cskilbeck/clock/Outputs/2020-09-30/Produce_DanZhi.SMT_Snapshot.Top.2367869A_Y37.SMT020093082196.png

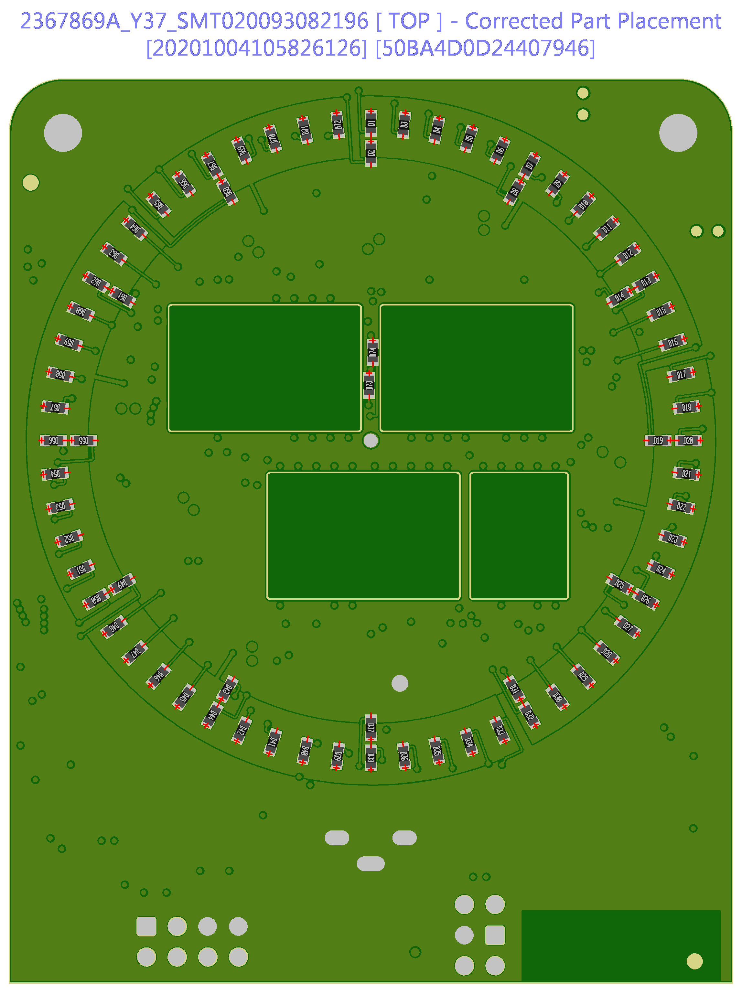
Outputs/2020-09-30/Produce_DanZhi.SMT_Snapshot.Top.2367869A_Y37.SMT020093082196.png
