cskilbeck/clock/Outputs/2020-09-30/SO2009306134.png

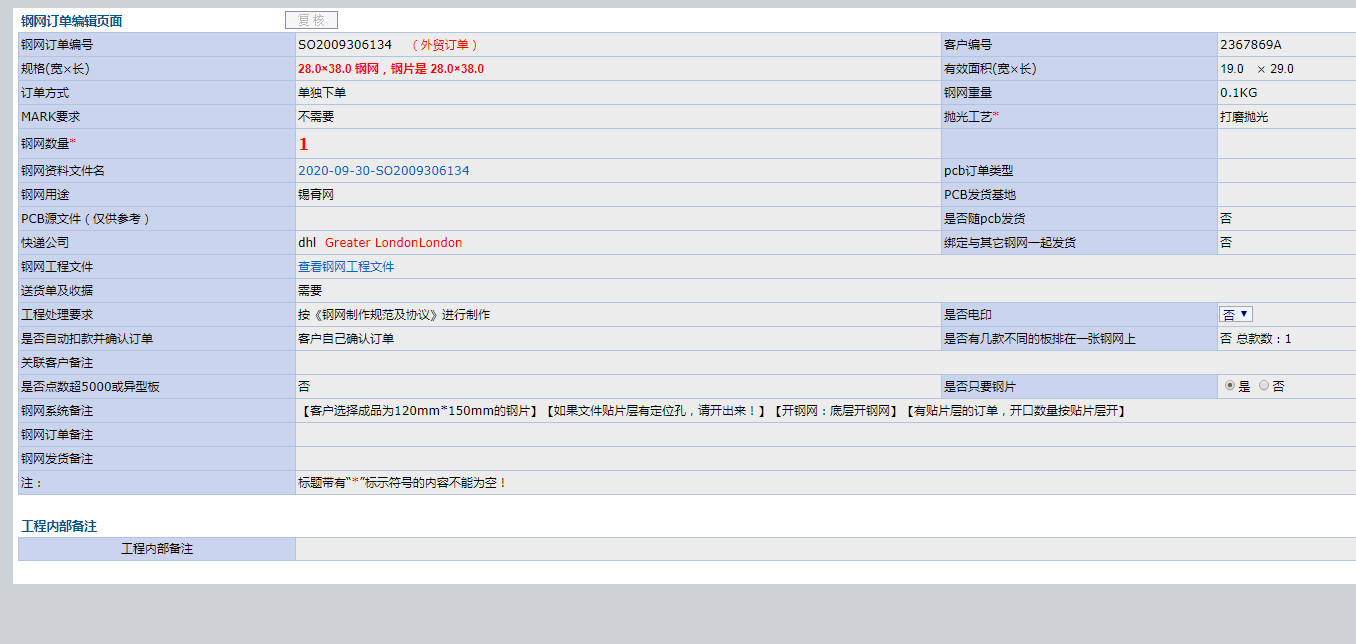
Outputs/2020-09-30/SO2009306134.png
