cskilbeck/clock/Outputs/2020-10-29/Produce_DanZhi.SMT_Snapshot.Top.2367869A_Y39.SMT020102993842.png

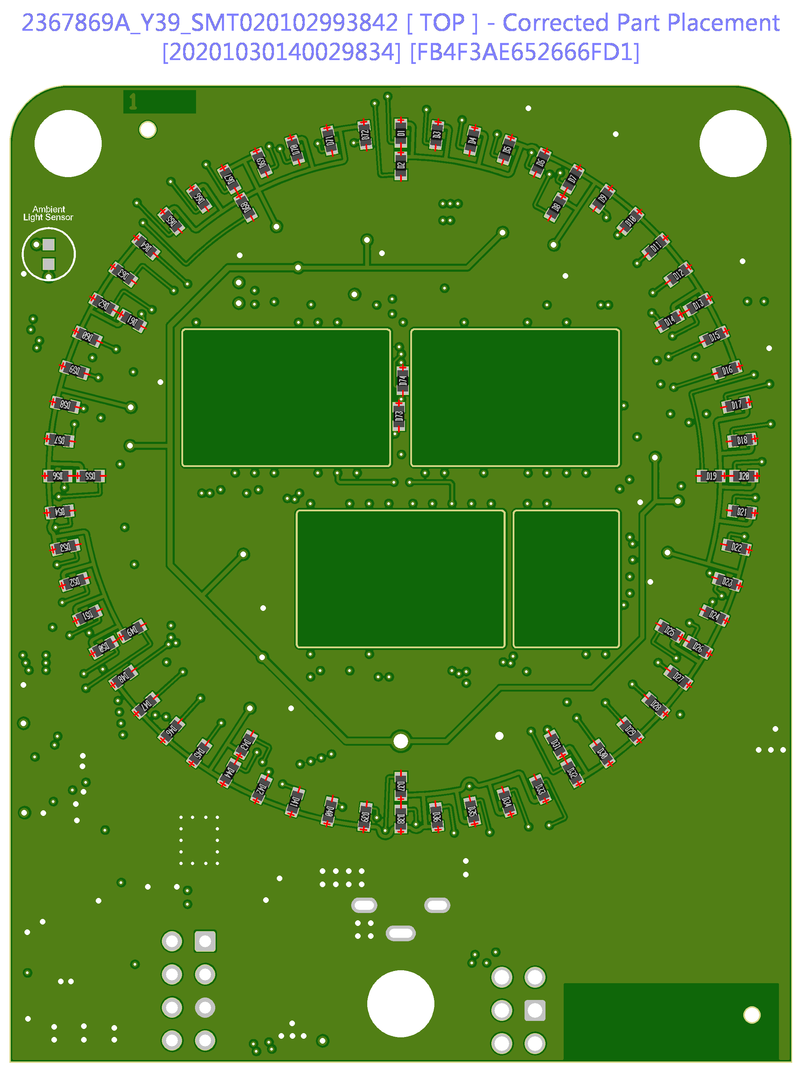
Outputs/2020-10-29/Produce_DanZhi.SMT_Snapshot.Top.2367869A_Y39.SMT020102993842.png
