cskilbeck/clock/Outputs/2020-11-24/BOM.xlsx

Comment | Designator | Footprint | LCSC Part #（optional）
LED | D1 | LED_0603 | C2286
LED | D2 | LED_0603 | C2286
LED | D3 | LED_0603 | C2286
LED | D4 | LED_0603 | C2286
LED | D5 | LED_0603 | C2286
LED | D6 | LED_0603 | C2286
LED | D7 | LED_0603 | C2286
LED | D8 | LED_0603 | C2286
LED | D9 | LED_0603 | C2286
LED | D10 | LED_0603 | C2286
LED | D11 | LED_0603 | C2286
LED | D12 | LED_0603 | C2286
LED | D13 | LED_0603 | C2286
LED | D14 | LED_0603 | C2286
LED | D15 | LED_0603 | C2286
LED | D16 | LED_0603 | C2286
LED | D17 | LED_0603 | C2286
LED | D18 | LED_0603 | C2286
LED | D19 | LED_0603 | C2286
LED | D20 | LED_0603 | C2286
LED | D21 | LED_0603 | C2286
LED | D22 | LED_0603 | C2286
LED | D23 | LED_0603 | C2286
LED | D24 | LED_0603 | C2286
LED | D25 | LED_0603 | C2286
LED | D26 | LED_0603 | C2286
LED | D27 | LED_0603 | C2286
LED | D28 | LED_0603 | C2286
LED | D29 | LED_0603 | C2286
LED | D30 | LED_0603 | C2286
LED | D31 | LED_0603 | C2286
LED | D32 | LED_0603 | C2286
LED | D33 | LED_0603 | C2286
LED | D34 | LED_0603 | C2286
LED | D35 | LED_0603 | C2286
LED | D36 | LED_0603 | C2286
LED | D37 | LED_0603 | C2286
LED | D38 | LED_0603 | C2286
LED | D39 | LED_0603 | C2286
LED | D40 | LED_0603 | C2286
LED | D41 | LED_0603 | C2286
LED | D42 | LED_0603 | C2286
LED | D43 | LED_0603 | C2286
LED | D44 | LED_0603 | C2286
LED | D45 | LED_0603 | C2286
LED | D46 | LED_0603 | C2286
LED | D47 | LED_0603 | C2286
LED | D48 | LED_0603 | C2286
LED | D49 | LED_0603 | C2286
LED | D50 | LED_0603 | C2286
LED | D51 | LED_0603 | C2286
LED | D52 | LED_0603 | C2286
LED | D53 | LED_0603 | C2286
LED | D54 | LED_0603 | C2286
LED | D55 | LED_0603 | C2286
LED | D56 | LED_0603 | C2286
LED | D57 | LED_0603 | C2286
LED | D58 | LED_0603 | C2286
LED | D59 | LED_0603 | C2286
LED | D60 | LED_0603 | C2286
LED | D61 | LED_0603 | C2286
LED | D62 | LED_0603 | C2286
LED | D63 | LED_0603 | C2286
LED | D64 | LED_0603 | C2286
LED | D65 | LED_0603 | C2286
LED | D66 | LED_0603 | C2286
LED | D67 | LED_0603 | C2286
LED | D68 | LED_0603 | C2286
LED | D69 | LED_0603 | C2286
LED | D70 | LED_0603 | C2286
LED | D71 | LED_0603 | C2286
LED | D72 | LED_0603 | C2286
LED | D73 | LED_0603 | C2286
LED | D74 | LED_0603 | C2286
