cskilbeck/clock/step/RV-8263-C7 v1.step

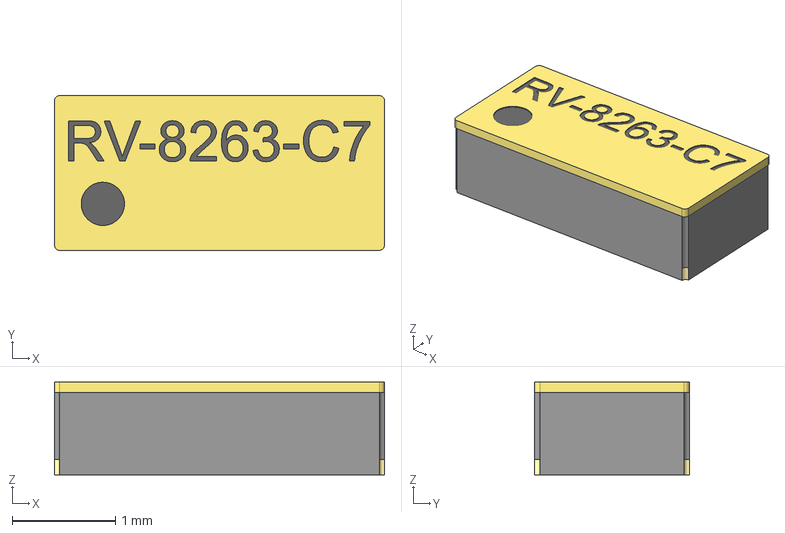
[picture p4: CAD file, 2020-11-23]
step/RV-8263-C7 v1.step
3.20 x 1.50 x 0.9 mm
