cskilbeck/clock/step/ACSA56-51.STEP

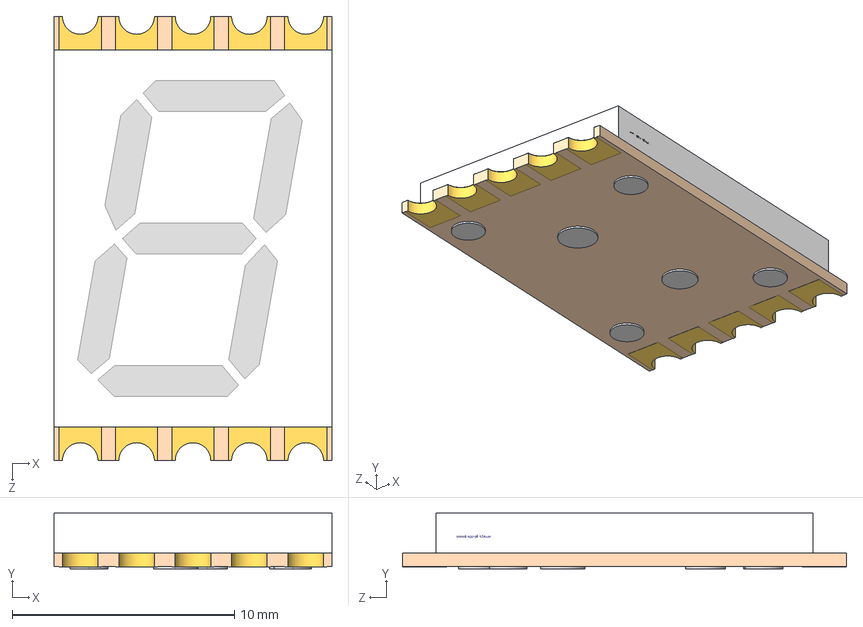
[picture p5: CAD file, 2020-11-18]
step/ACSA56-51.STEP
12.5 x 2.50 x 20.0 mm
