cskilbeck/clock/step/KCSA03-105.1.step

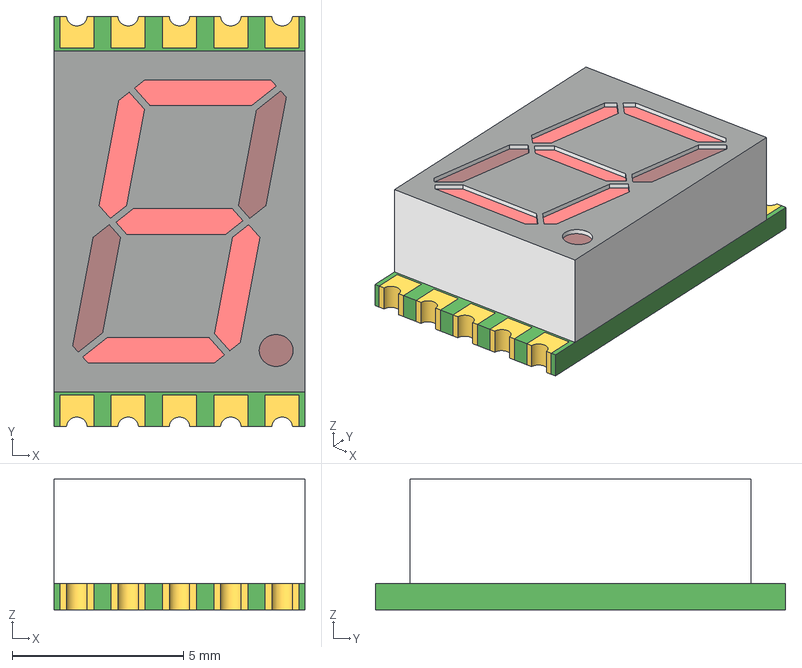
[picture p6: CAD file, 2020-11-05]
step/KCSA03-105.1.step
7.34 x 12.0 x 3.83 mm
