cskilbeck/clock/step/ALS-PDIC144-6C.STEP

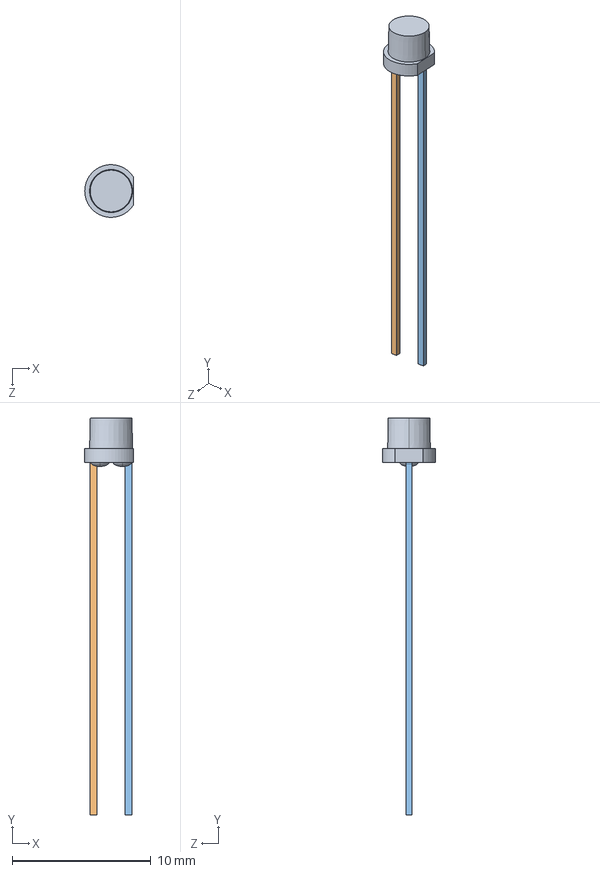
[picture p7: CAD file, 2020-11-05]
step/ALS-PDIC144-6C.STEP
3.50 x 28.6 x 3.80 mm
