cskilbeck/clock/step/DSM7UA30101.STEP

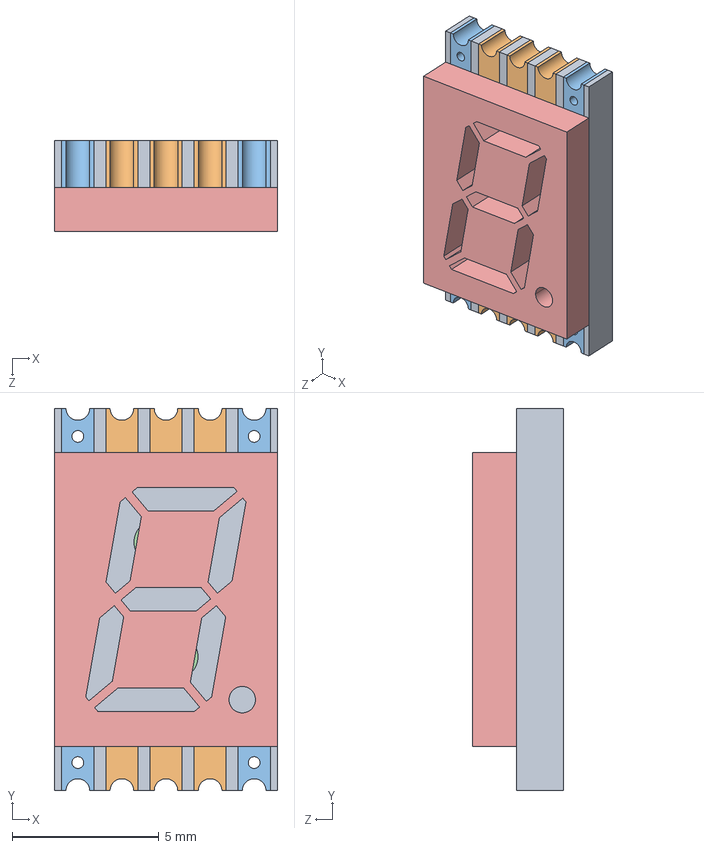
[picture p8: CAD file, 2020-11-05]
step/DSM7UA30101.STEP
7.60 x 13.0 x 3.10 mm
S3012PCB.1.STEP
S3012PCB.2.STEP x 6
S3012PCB.3.STEP x 4
S3012PCB.4.STEP x 2
S3012___r.STEP
