cskilbeck/clock/step/ALS-PDIC144-6C_BENT_LEGS4.step

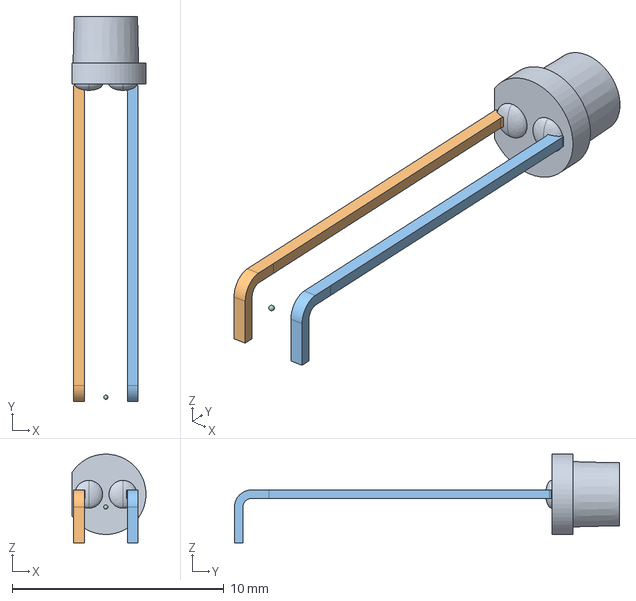
[picture p9: CAD file, 2020-11-05]
step/ALS-PDIC144-6C_BENT_LEGS4.step
3.50 x 18.2 x 4.20 mm
