cskilbeck/clock/step/ALS-PDIC144-6C_BENT_LEGS.step

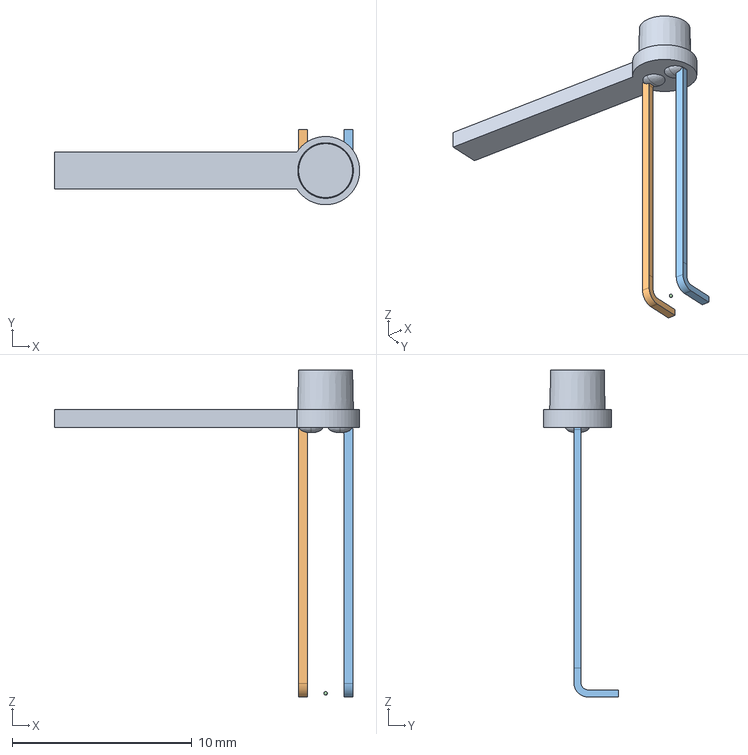
[picture p11: CAD file, 2020-11-05]
step/ALS-PDIC144-6C_BENT_LEGS.step
17.0 x 4.20 x 18.2 mm
