cskilbeck/clock/step/LED_0603_KT-0603R.step

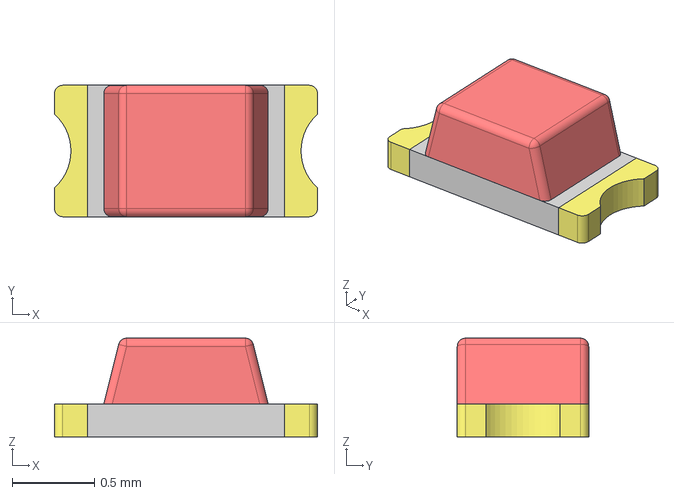
[picture p13: CAD file, 2020-10-22]
step/LED_0603_KT-0603R.step
1.60 x 0.8 x 0.6 mm
