cskilbeck/clock/step/ALS_2012_0805_R5.step

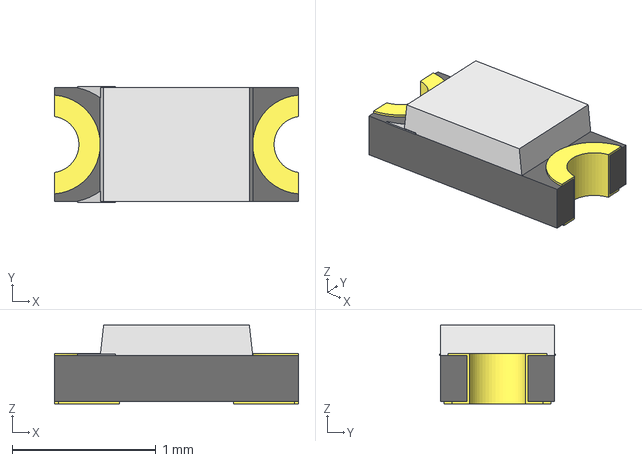
[picture p14: CAD file, 2020-10-13]
step/ALS_2012_0805_R5.step
1.70 x 0.807 x 0.547 mm
