cskilbeck/clock/step/ALS_2012_0805_r3.step

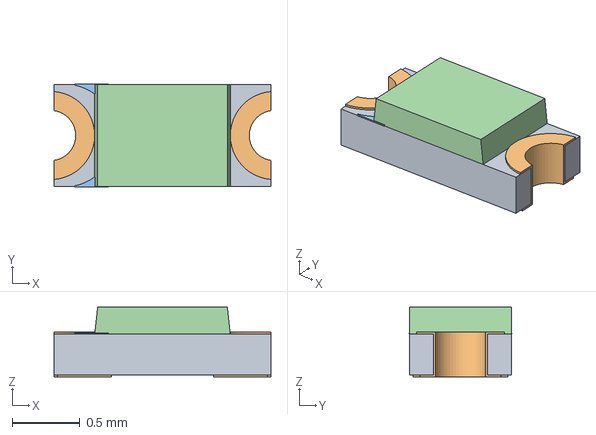
[picture p15: CAD file, 2020-10-13]
step/ALS_2012_0805_r3.step
1.60 x 0.759 x 0.515 mm
