cskilbeck/clock/step/usb_connector v8.step

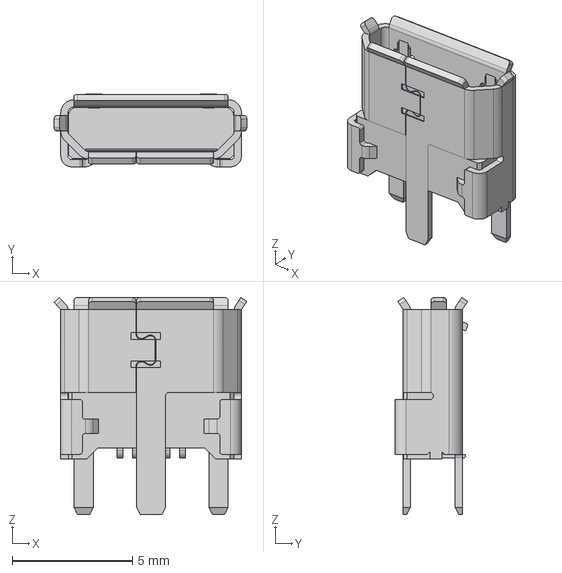
[picture p16: CAD file, 2020-10-13]
step/usb_connector v8.step
8.00 x 3.01 x 9.01 mm
