cskilbeck/clock/step/ALS_2012_0805_R2.step

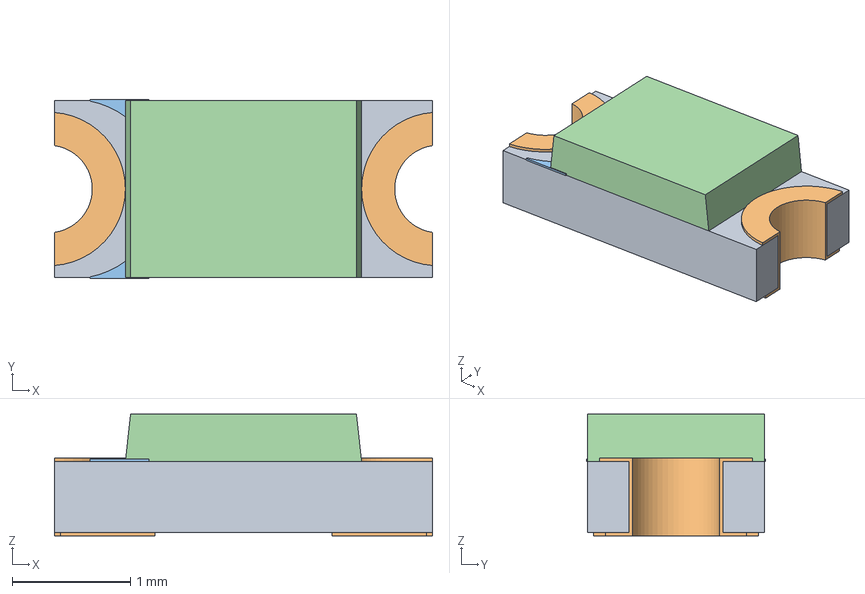
[picture p17: CAD file, 2020-10-13]
step/ALS_2012_0805_R2.step
3.20 x 1.52 x 1.03 mm
