cskilbeck/clock/step/RK10J1_E.STEP

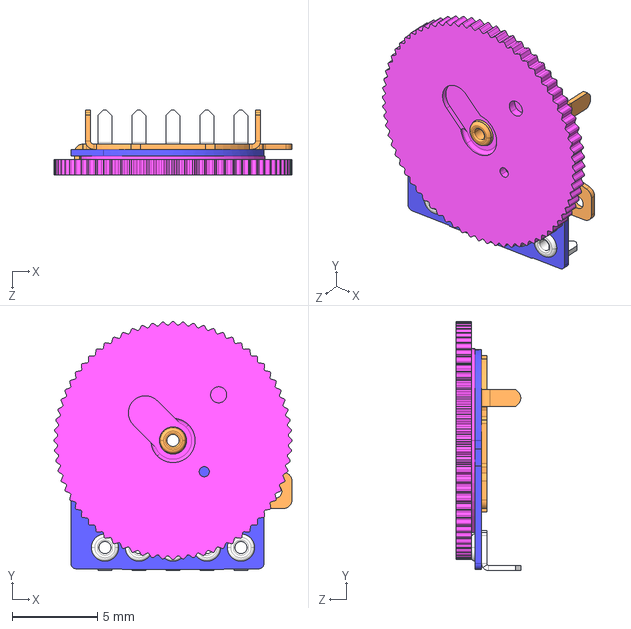
[picture p18: CAD file, 2020-10-13]
step/RK10J1_E.STEP
14.0 x 14.6 x 3.80 mm
