cskilbeck/clock/step/RK10J1_R.STEP

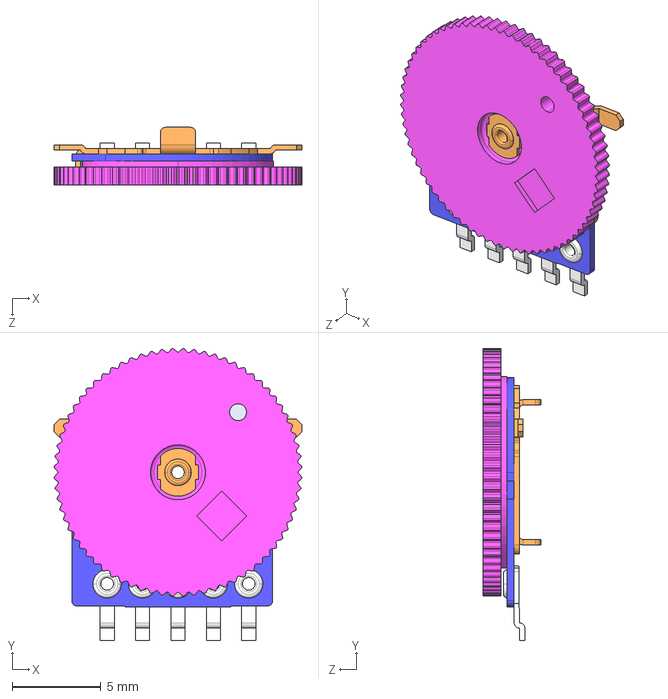
[picture p19: CAD file, 2020-10-13]
step/RK10J1_R.STEP
14.0 x 16.5 x 3.25 mm
