cskilbeck/clock/(list of files, cad)

Other CAD files:
step/ALS-PDIC144-6C_BENT_LEGS3.step
step/ALS-PDIC144-6C_BENT_LEGS2.step
step/KCSA03-105.step
step/ALS_2012_0805_r4.step
step/ALS_2012_0805.STEP
step/DSM7UA30101_rev01.step
