cskilbeck/clock/Outputs/2020-11-24/clock.PDF

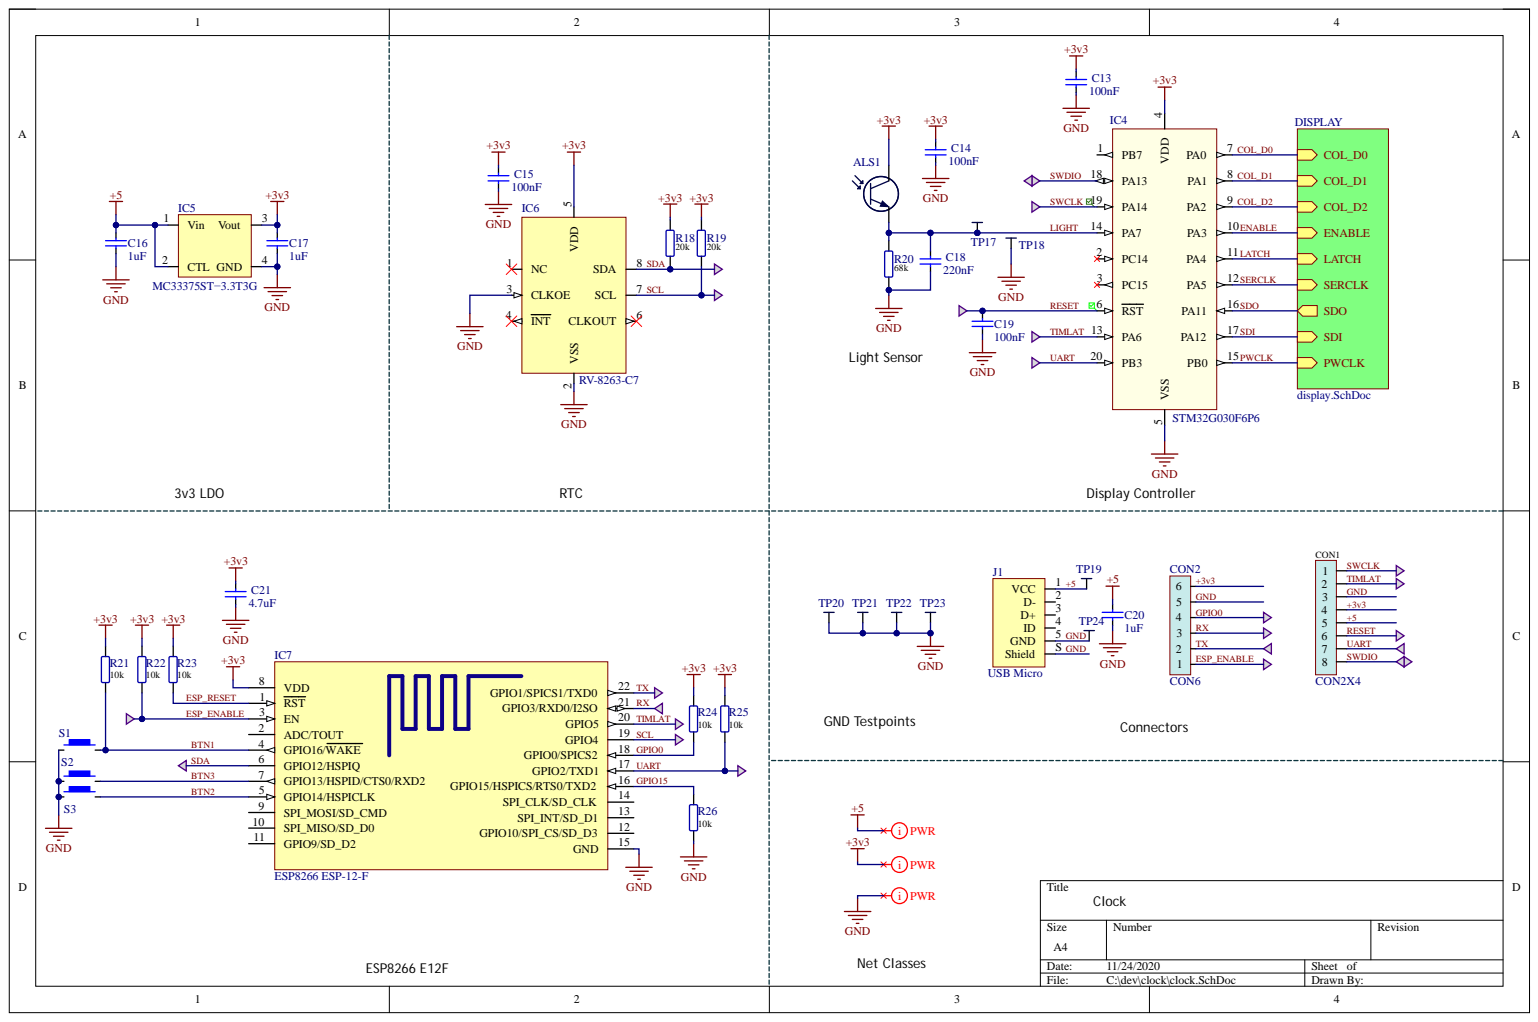
[picture p20: page 1]

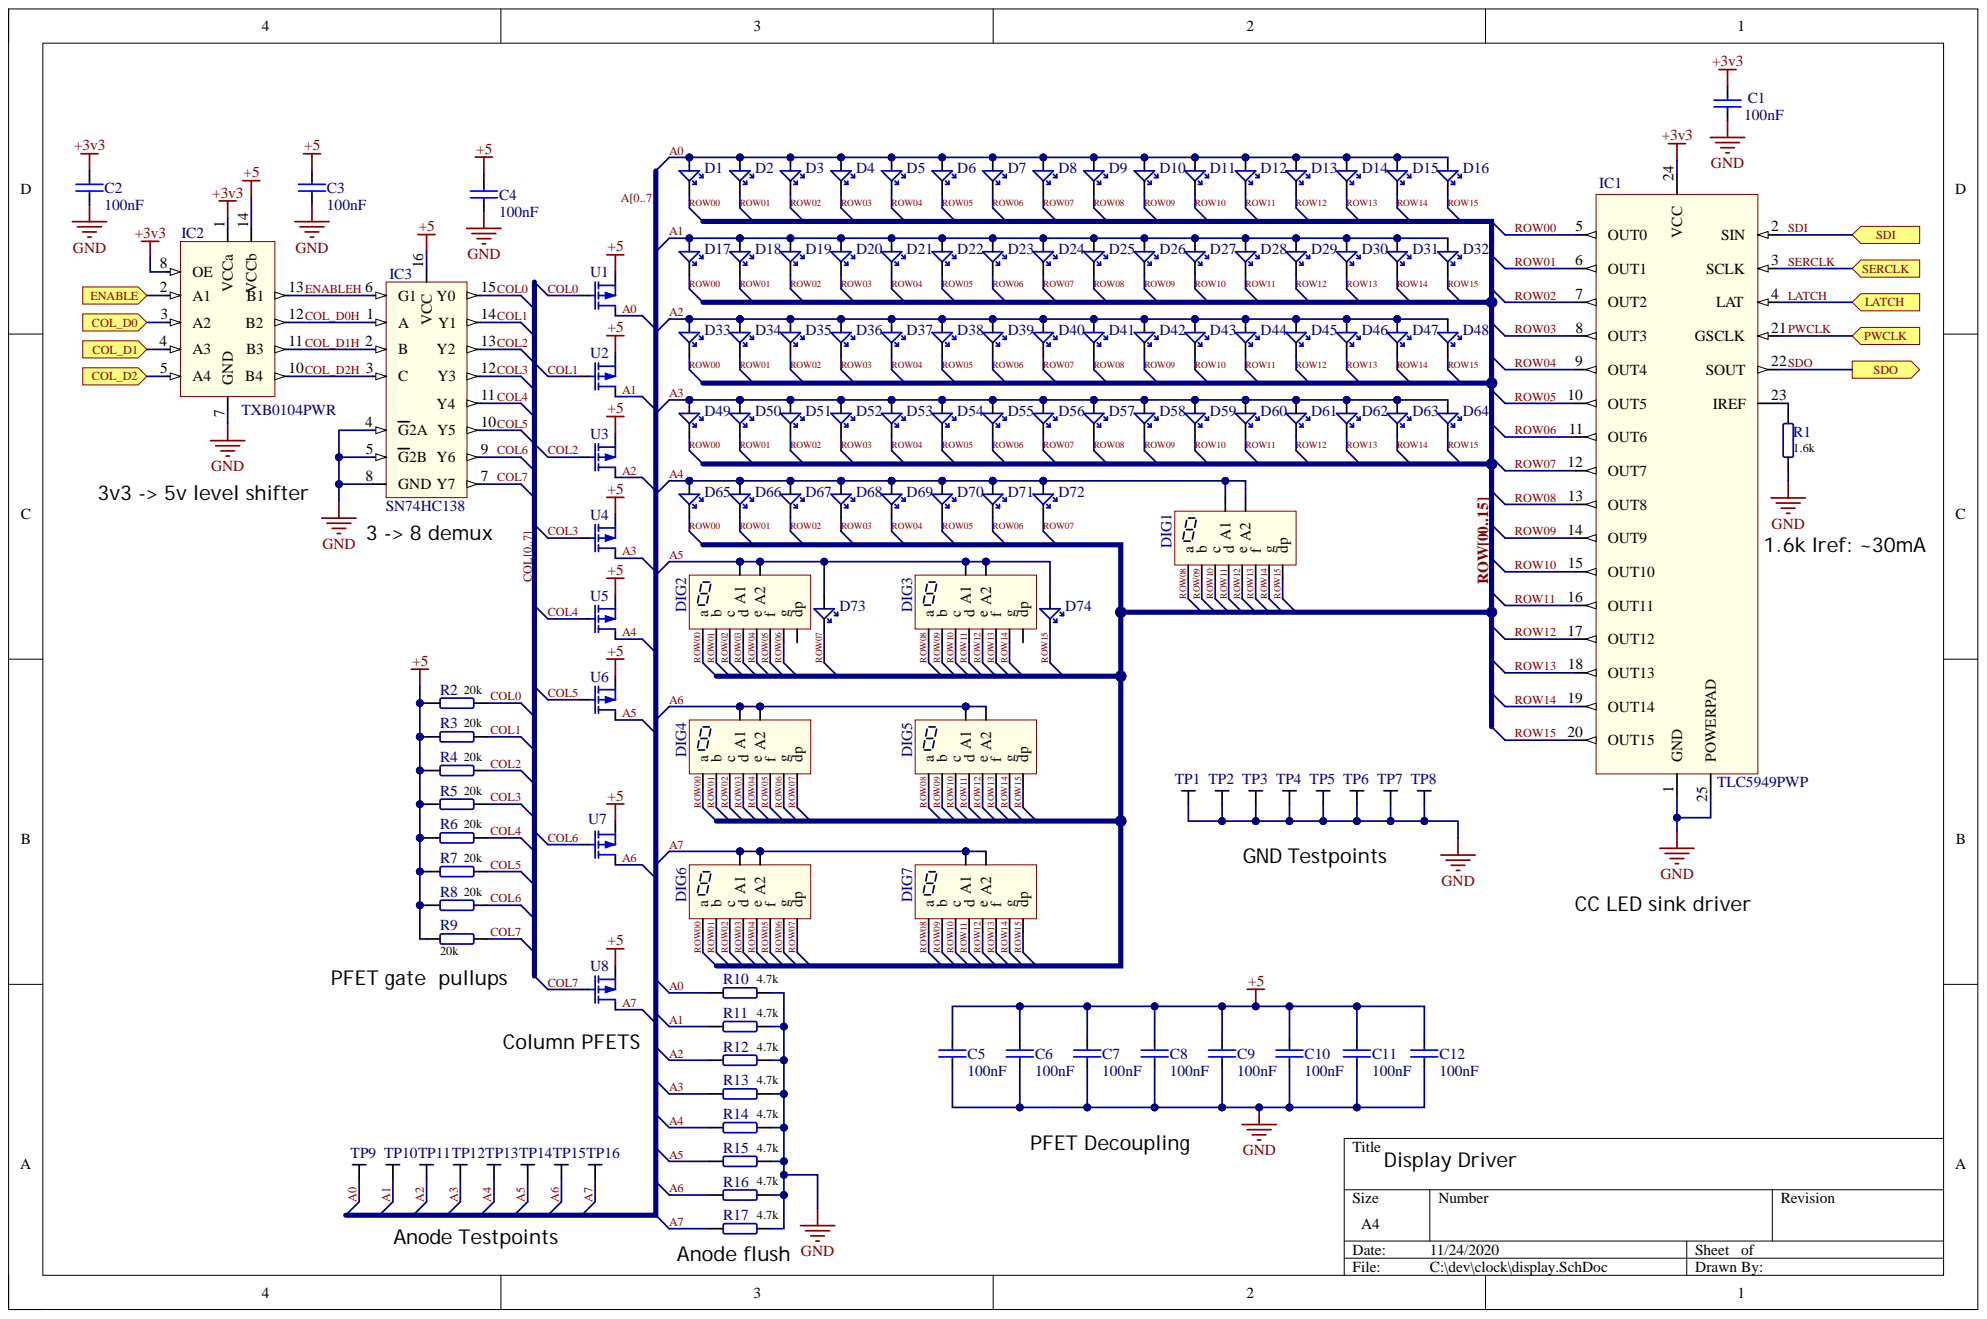
[picture p21: page 2]

CC LED sink driver

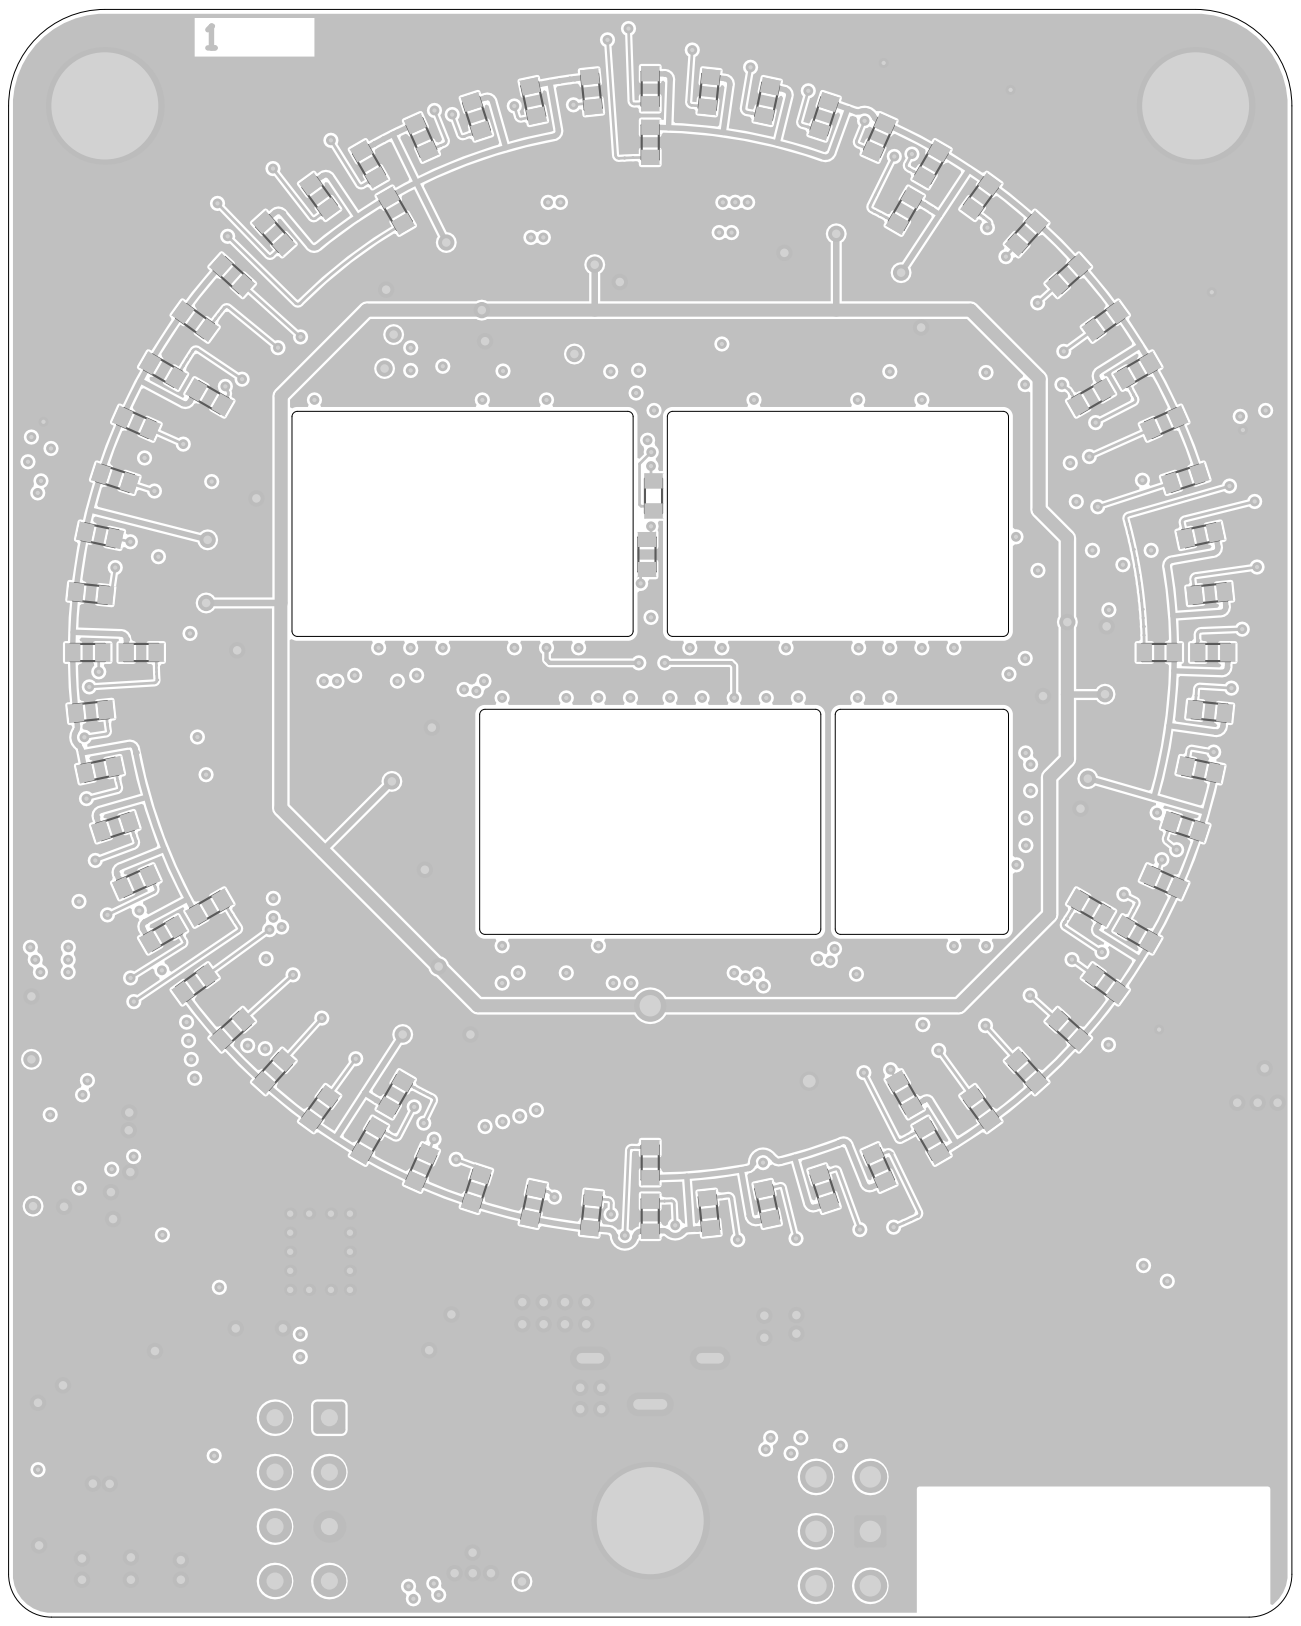
[picture p22: page 3]

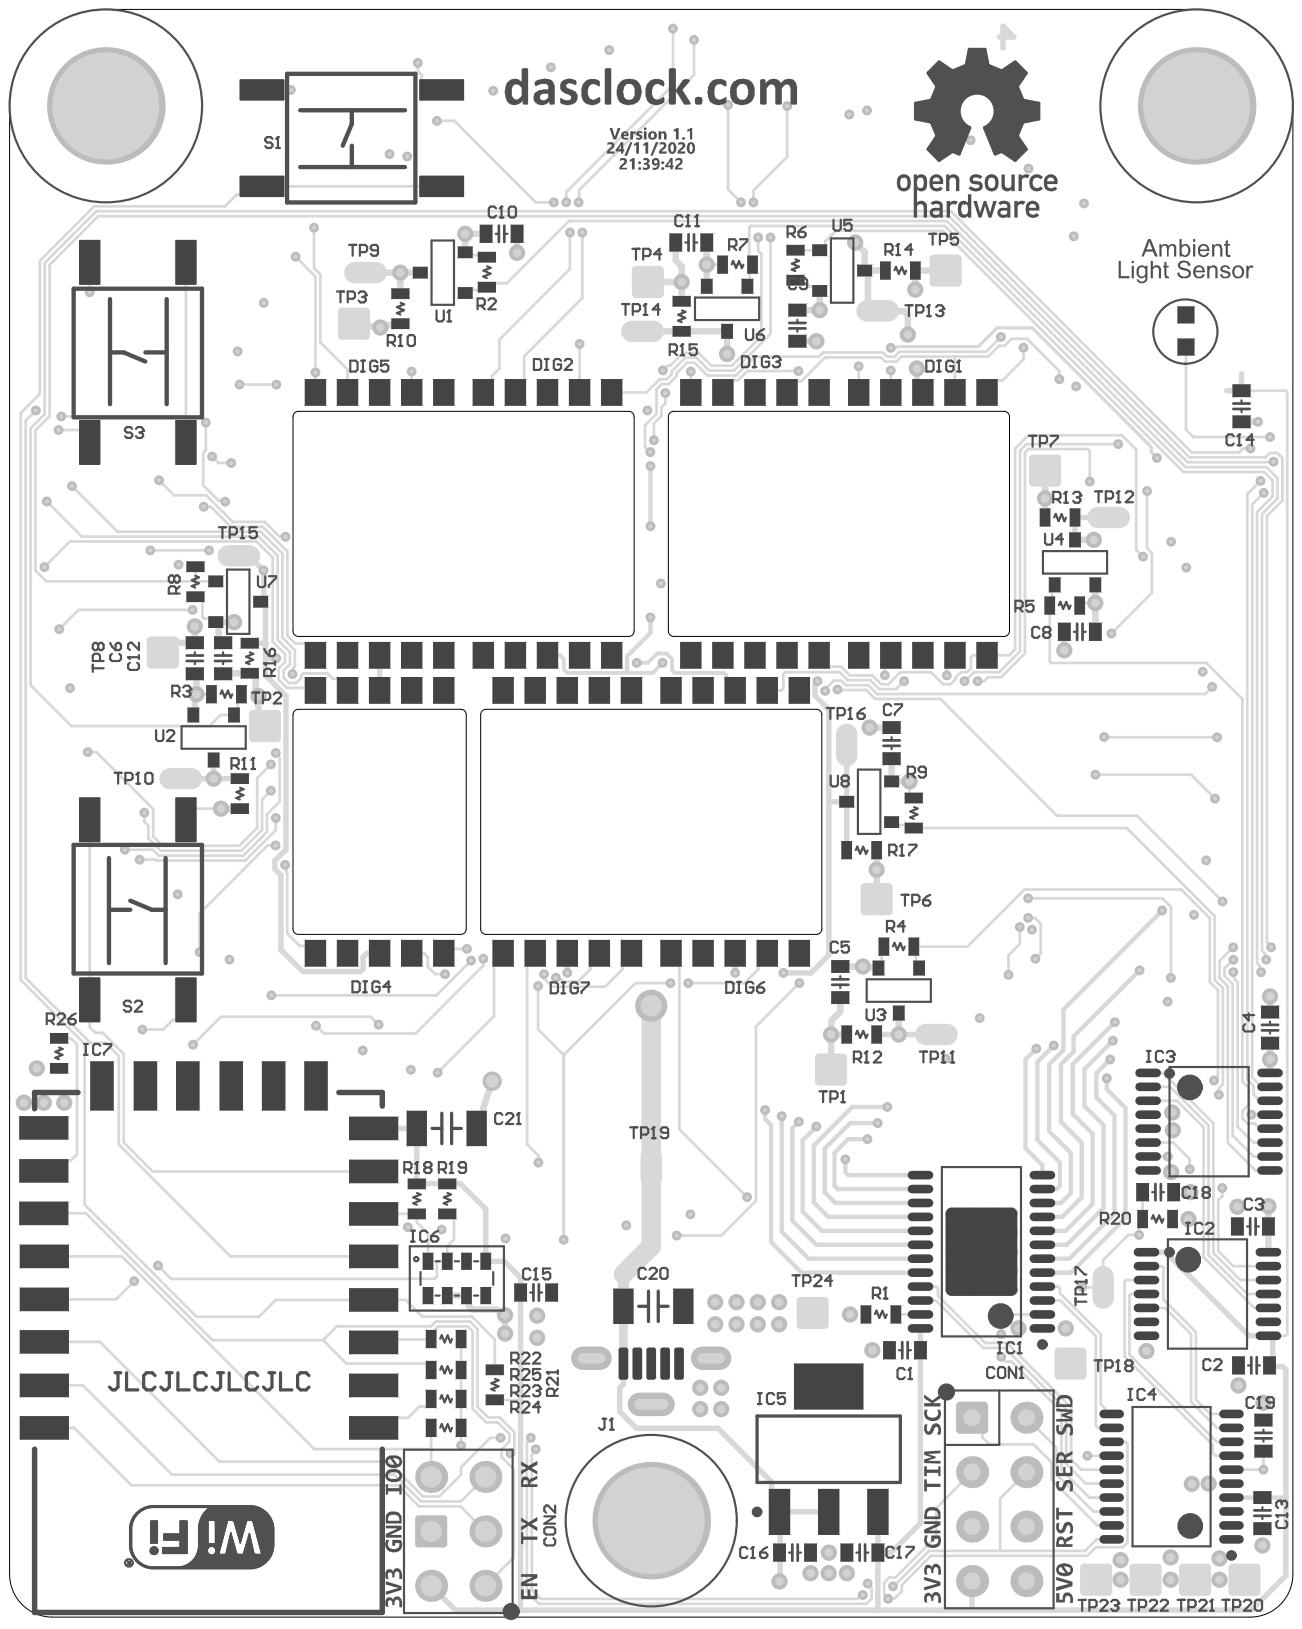
[picture p23: page 4]

Designator | Value | Quantity | Name | Footprint | Description
ALS1 | | 1 PHOTOTRANSISTOR | | ALS-PT19-315C | Photo transistor
C1-C15, C19 | 100nF | 16 Cap | | CAPC_0603_1608X08L | Capacitor
C16, C17 | 1uF | 2 Cap | | CAPC_0603_1608X08L | Capacitor
C18 | 220nF | 1 Cap | | CAPC_0603_1608X08L | Capacitor
C20 | 1uF | 1 Cap | | CAPC_1206_3216X16L | Capacitor
C21 | 4.7uF | 1 Cap | | CAPC_1206_3216X16L | Capacitor
D1-D74 | | 74 LED | | 0603 Chip SMD LED | Red 0603 SMD LED
DIG1-DIG7 | | 7 KCSA03-105 | | KCSA03105 | Low profile 7 segment digit
IC1 | | 1 TLC5949PWP | | TSOP65P640X120-24L - POWERPAD | 16 channel cc sink led driver
IC2 | | 1 TXB0104PWR | | TSOP65P640X120-14L | 4 channel level shifter
IC3 | | 1 SN74HC138 | | TSOP65P640X110-16L | 3 -> 8 demux
IC4 | | 1 STM32G030F6P6 | | TSOP65P630X120-20L | MCU 64MHz tssop20
IC5 | | 1 MC33375ST−3.3T3G | | SOT230P700X180-4N | 3.3v LDO
IC6 | | 1 RV-8263-C7 | | RV-8263-C7
IC7 | | 1 ESP8266 ESP-12-F | | ESP8266 ESP-12-E | ESP8266 ESP-12-F
J1 | | 1 USB Micro | | USB 1051330011 | USB 2.0 Type B Micro vertical SMT
R1 | 1.6k | 1 RES0603 | | RESC1608X03L | Chip Resistor
R2-R9, R18, R19 | 20k | 10 RES0603 | | RESC1608X03L | Chip Resistor
R10-R17 | 4.7k | 8 RES0603 | | RESC1608X03L | Chip Resistor
R20 | 68k | 1 RES0603 | | RESC1608X03L | Chip Resistor
R21-R26 | 10k | 6 RES0603 | | RESC1608X03L | Chip Resistor
S1-S3 | | 3 4-1437565-1 | | FSM-SWITCH | 6x6mm SMD tactile switch,SPST-NO
U1-U8 | | 8 MOSFET-P | | SOT95P230X110-3L | P channel mosfet 1.2A

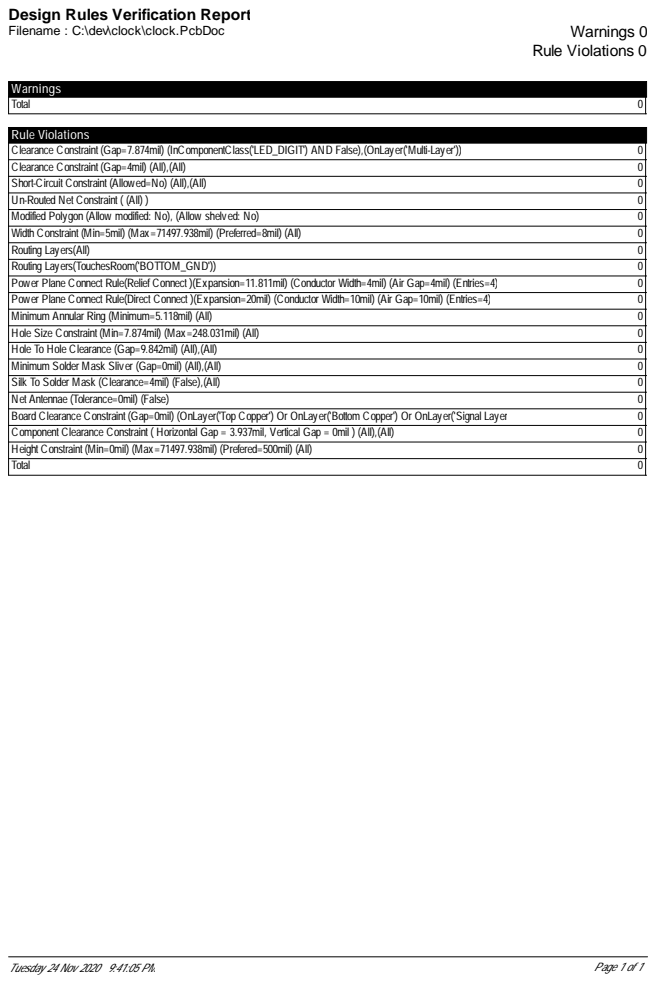
[picture p24: page 6]

Design Rules Verification Report

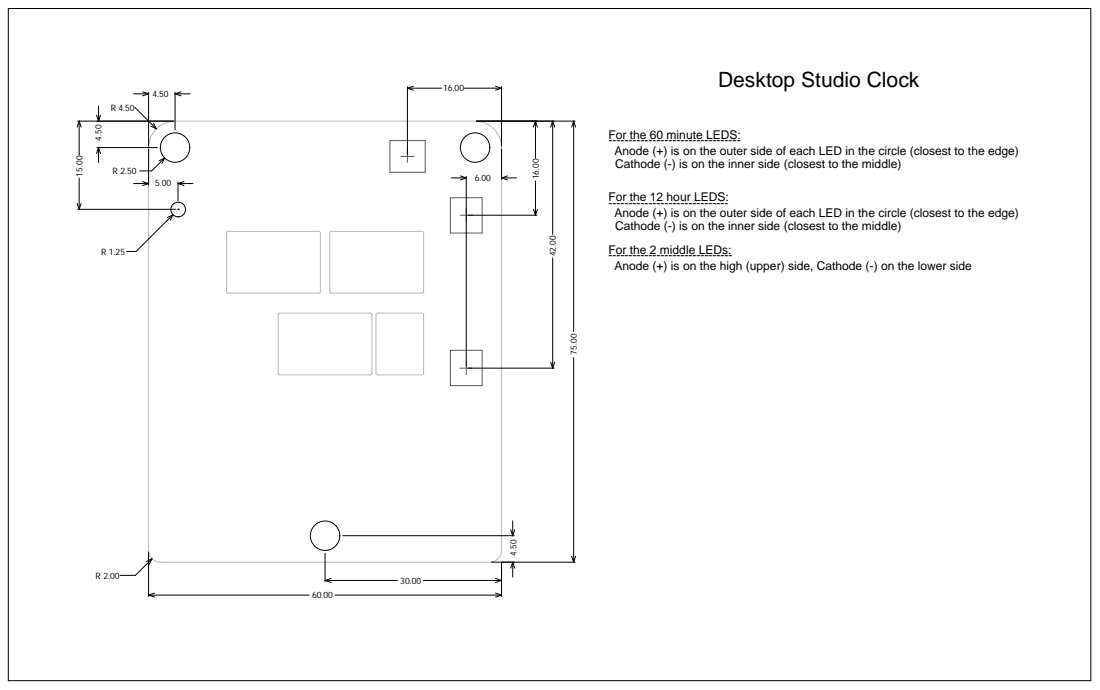
[picture p25: page 7]

For the 60 minute LEDS:
Anode (+) is on the outer side of each LED in the circle (closest to the edge)
Cathode (-) is on the inner side (closest to the middle)

For the 12 hour LEDS:

For the 2 middle LEDs:
Anode (+) is on the high (upper) side, Cathode (-) on the lower side
