cskilbeck/clock/Outputs/2020-10-29/clock.PDF

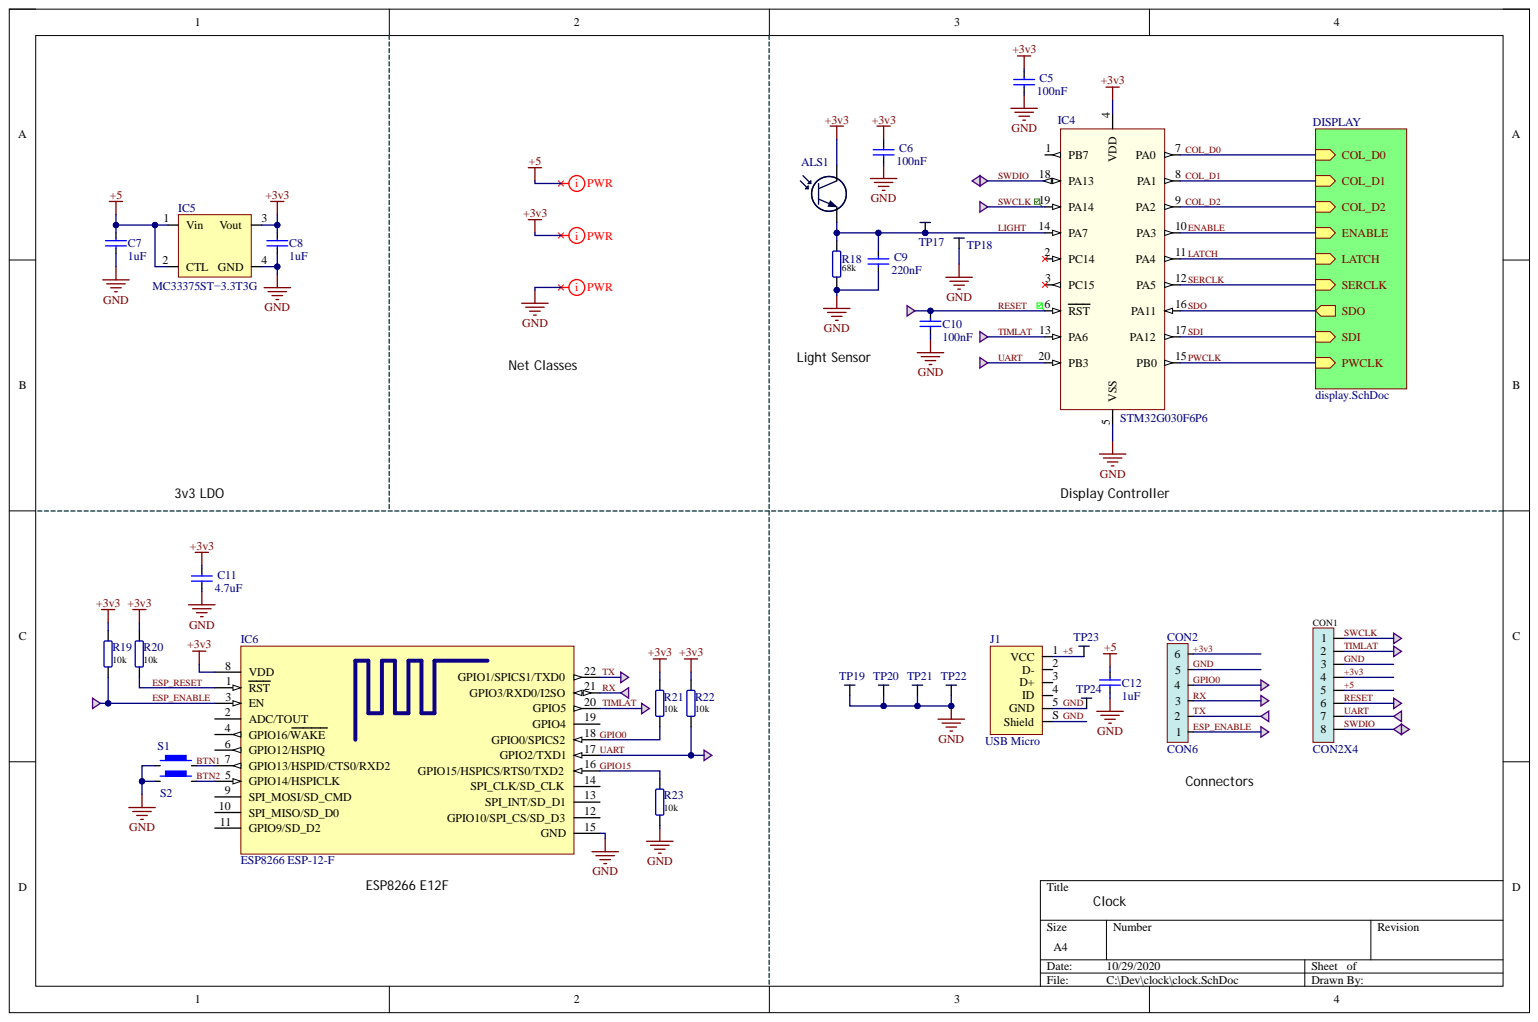
[picture p26: page 1]

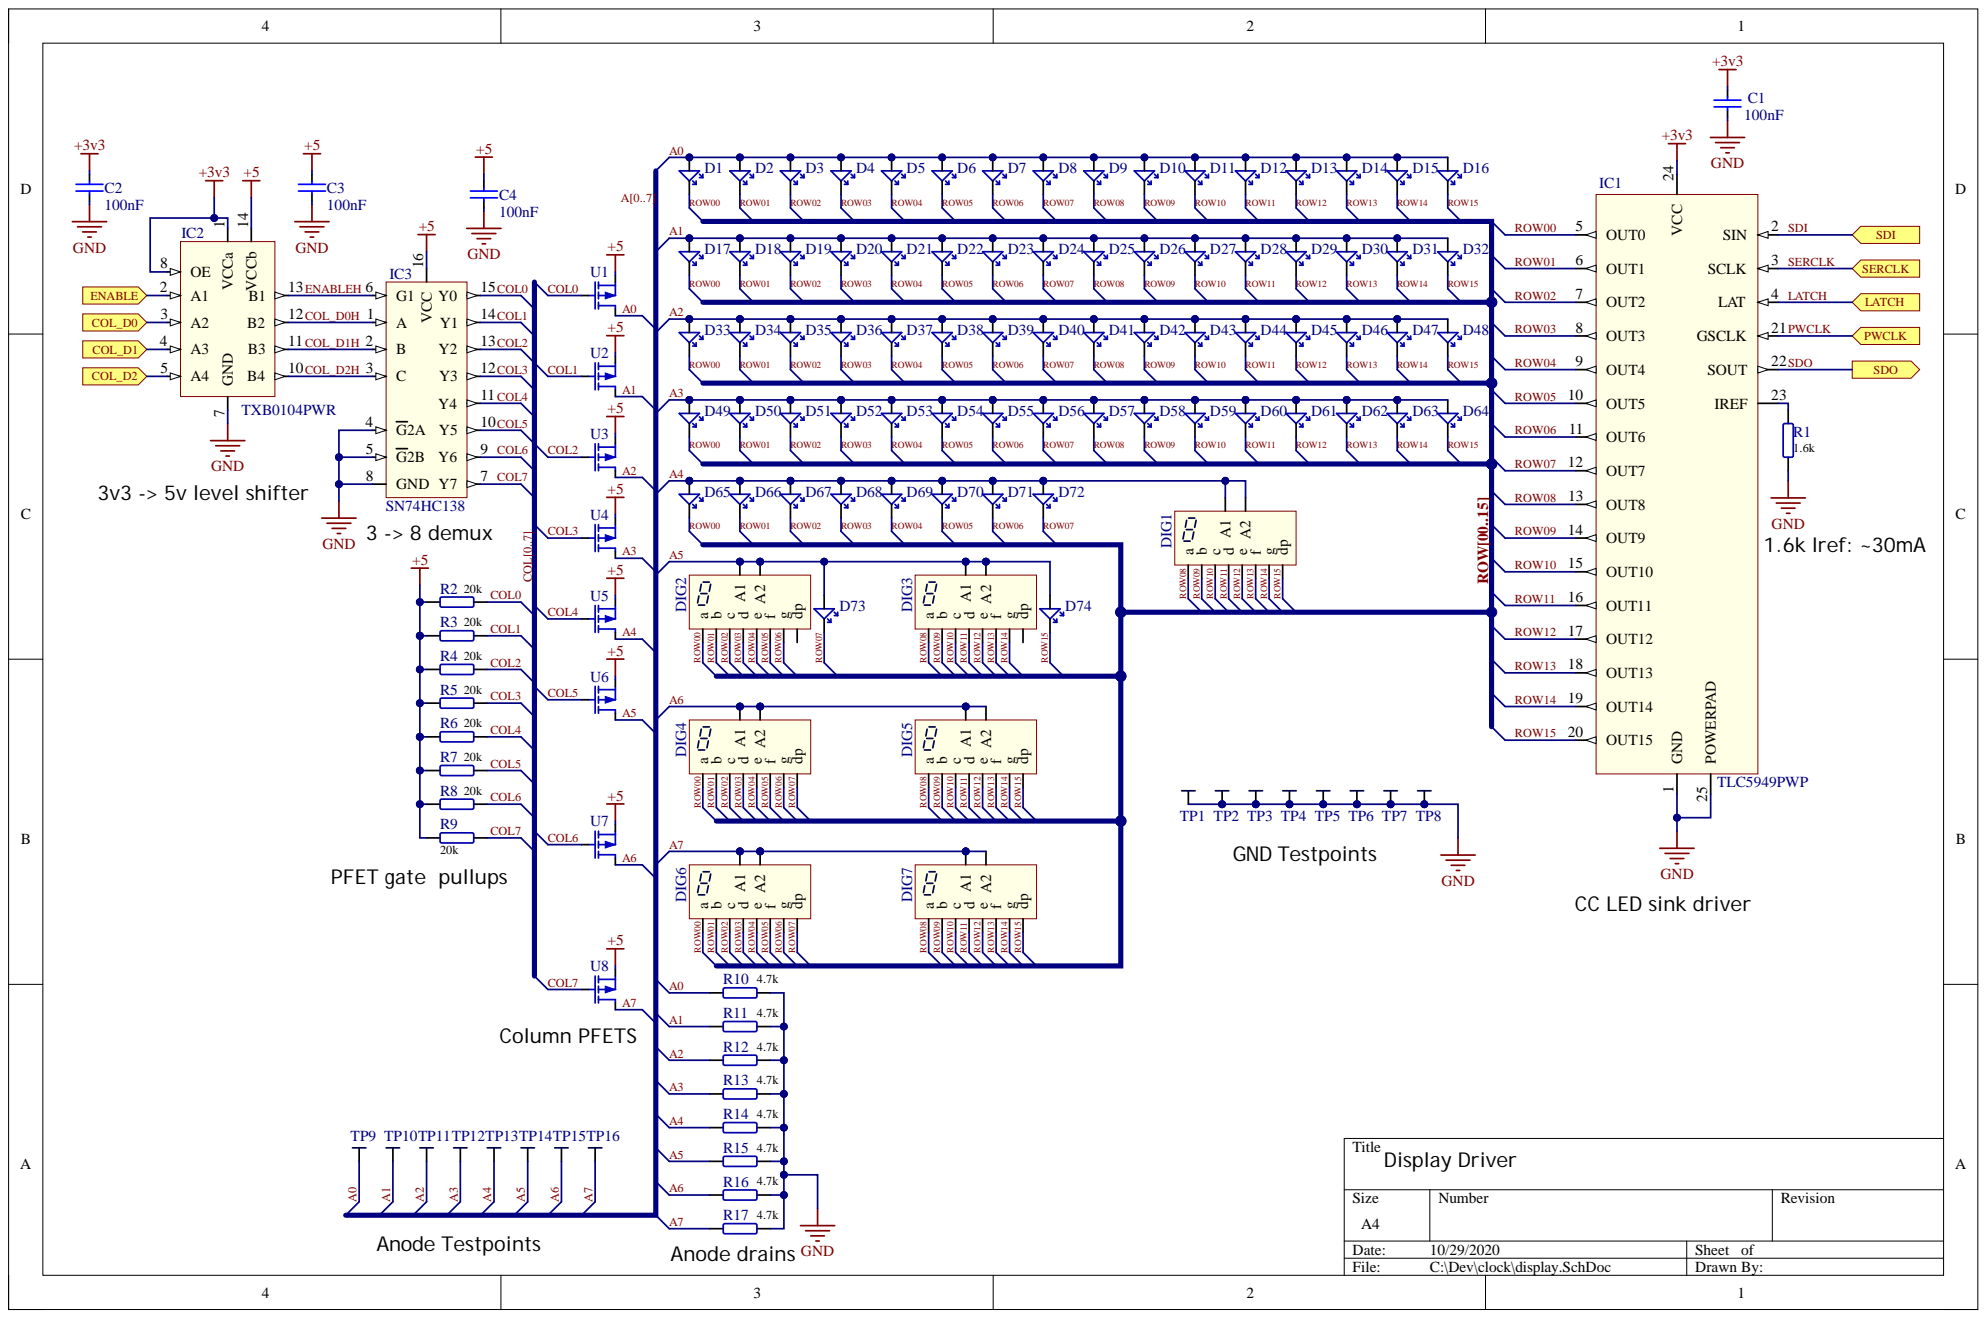
[picture p27: page 2]

1 1 COL_D1 | H 2

COL_D2 | 3 H

CC LED sink driver

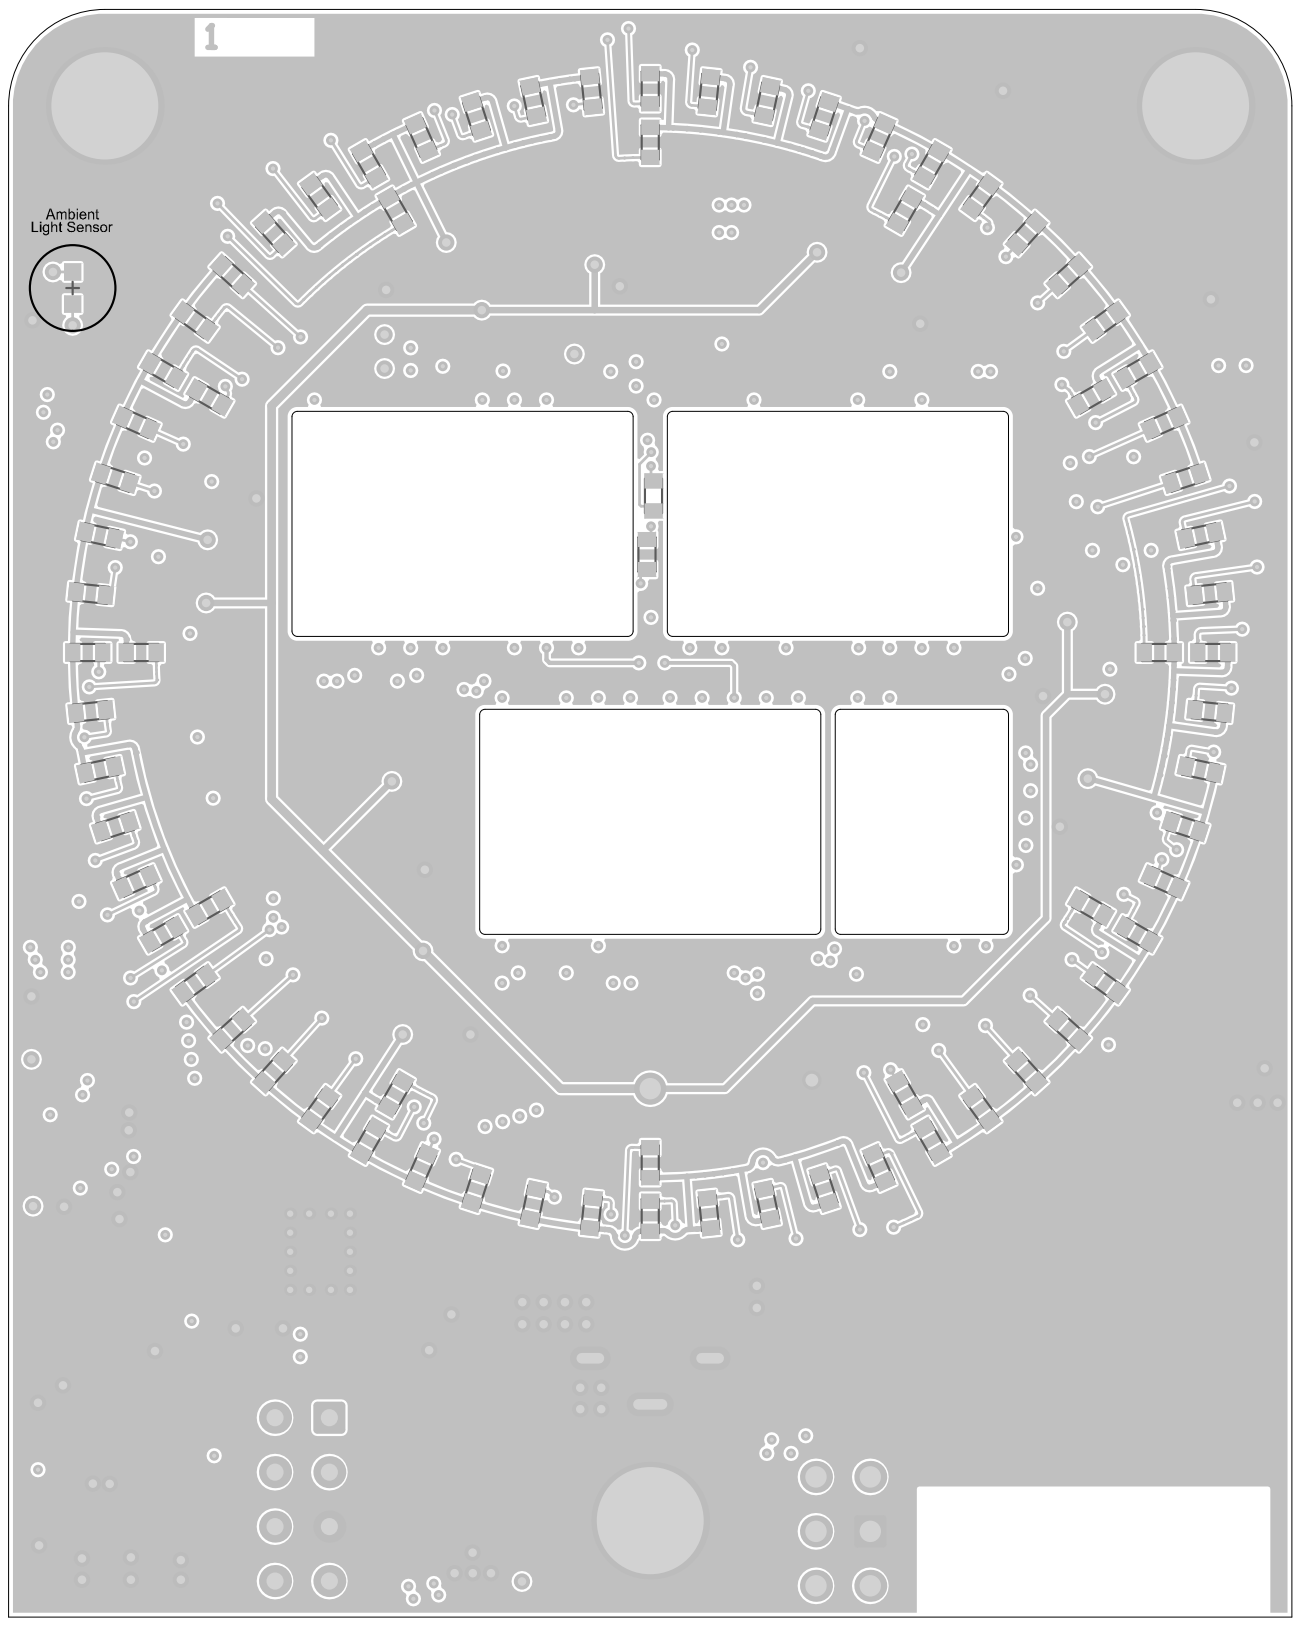
[picture p28: page 3]

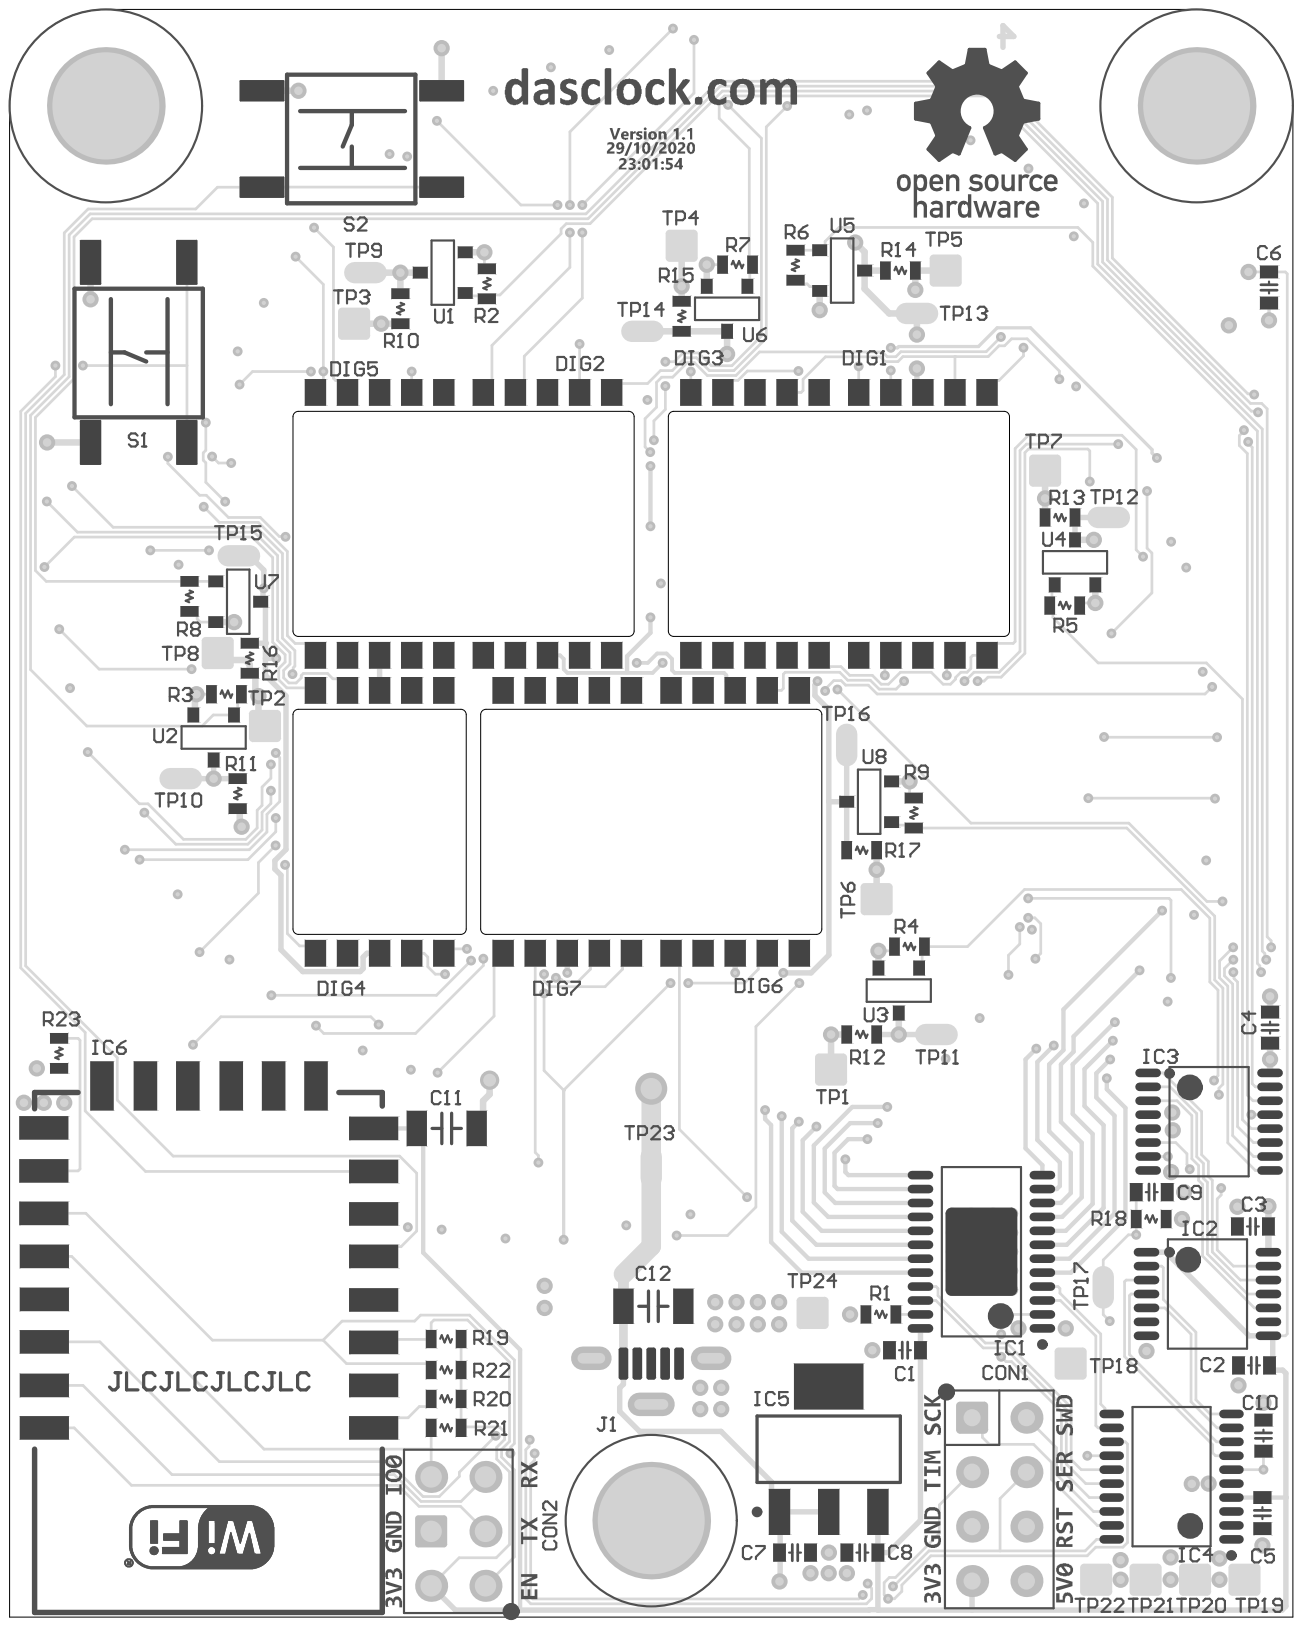
[picture p29: page 4]

Designator | Value | Quantity | Name | Footprint | Description
ALS1 | | 1 PHOTOTRANSISTOR | | ALS-PT19-315C | Photo transistor
C1-C6, C10 | 100nF | 7 Cap | | CAPC_0603_1608X08L | Capacitor
C7, C8 | 1uF | 2 Cap | | CAPC_0603_1608X08L | Capacitor
C9 | 220nF | 1 Cap | | CAPC_0603_1608X08L | Capacitor
C11 | 4.7uF | 1 Cap | | CAPC_1206_3216X16L | Capacitor
C12 | 1uF | 1 Cap | | CAPC_1206_3216X16L | Capacitor
D1-D74 | | 74 LED | | 0603 Chip SMD LED | Red 0603 SMD LED
DIG1-DIG7 | | 7 KCSA03-105 | | KCSA03105 | Low profile 7 segment digit
IC1 | | 1 TLC5949PWP | | TSOP65P640X120-24L - POWERPAD | 16 channel cc sink led driver
IC2 | | 1 TXB0104PWR | | TSOP65P640X120-14L | 4 channel level shifter
IC3 | | 1 SN74HC138 | | TSOP65P640X110-16L | 3 -> 8 demux
IC4 | | 1 STM32G030F6P6 | | TSOP65P630X120-20L | MCU 64MHz tssop20
IC5 | | 1 MC33375ST−3.3T3G | | SOT230P700X180-4N | 3.3v LDO
IC6 | | 1 ESP8266 ESP-12-F | | ESP8266 ESP-12-E | ESP8266 ESP-12-F
J1 | | 1 USB Micro | | USB 1051330011 | USB 2.0 Type B Micro vertical SMT
R1 | 1.6k | 1 RES0603 | | RESC1608X03L | Chip Resistor
R2-R9 | 20k | 8 RES0603 | | RESC1608X03L | Chip Resistor
R10-R17 | 4.7k | 8 RES0603 | | RESC1608X03L | Chip Resistor
R18 | 68k | 1 RES0603 | | RESC1608X03L | Chip Resistor
R19-R23 | 10k | 5 RES0603 | | RESC1608X03L | Chip Resistor
S1, S2 | | 2 4-1437565-1 | | FSM-SWITCH | 6x6mm SMD tactile switch,SPST-NO
U1-U8 | | 8 MOSFET-P | | SOT95P230X110-3L | P channel mosfet 1.2A

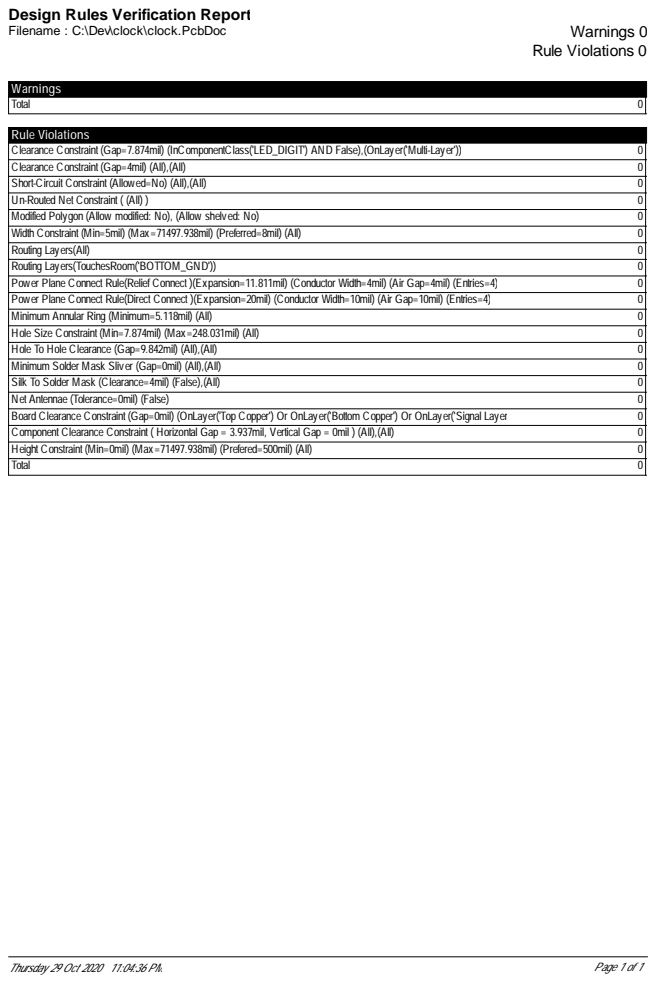
[picture p30: page 6]

Design Rules Verification Report
