cskilbeck/clock/Outputs/2020-09-30/clock.PDF

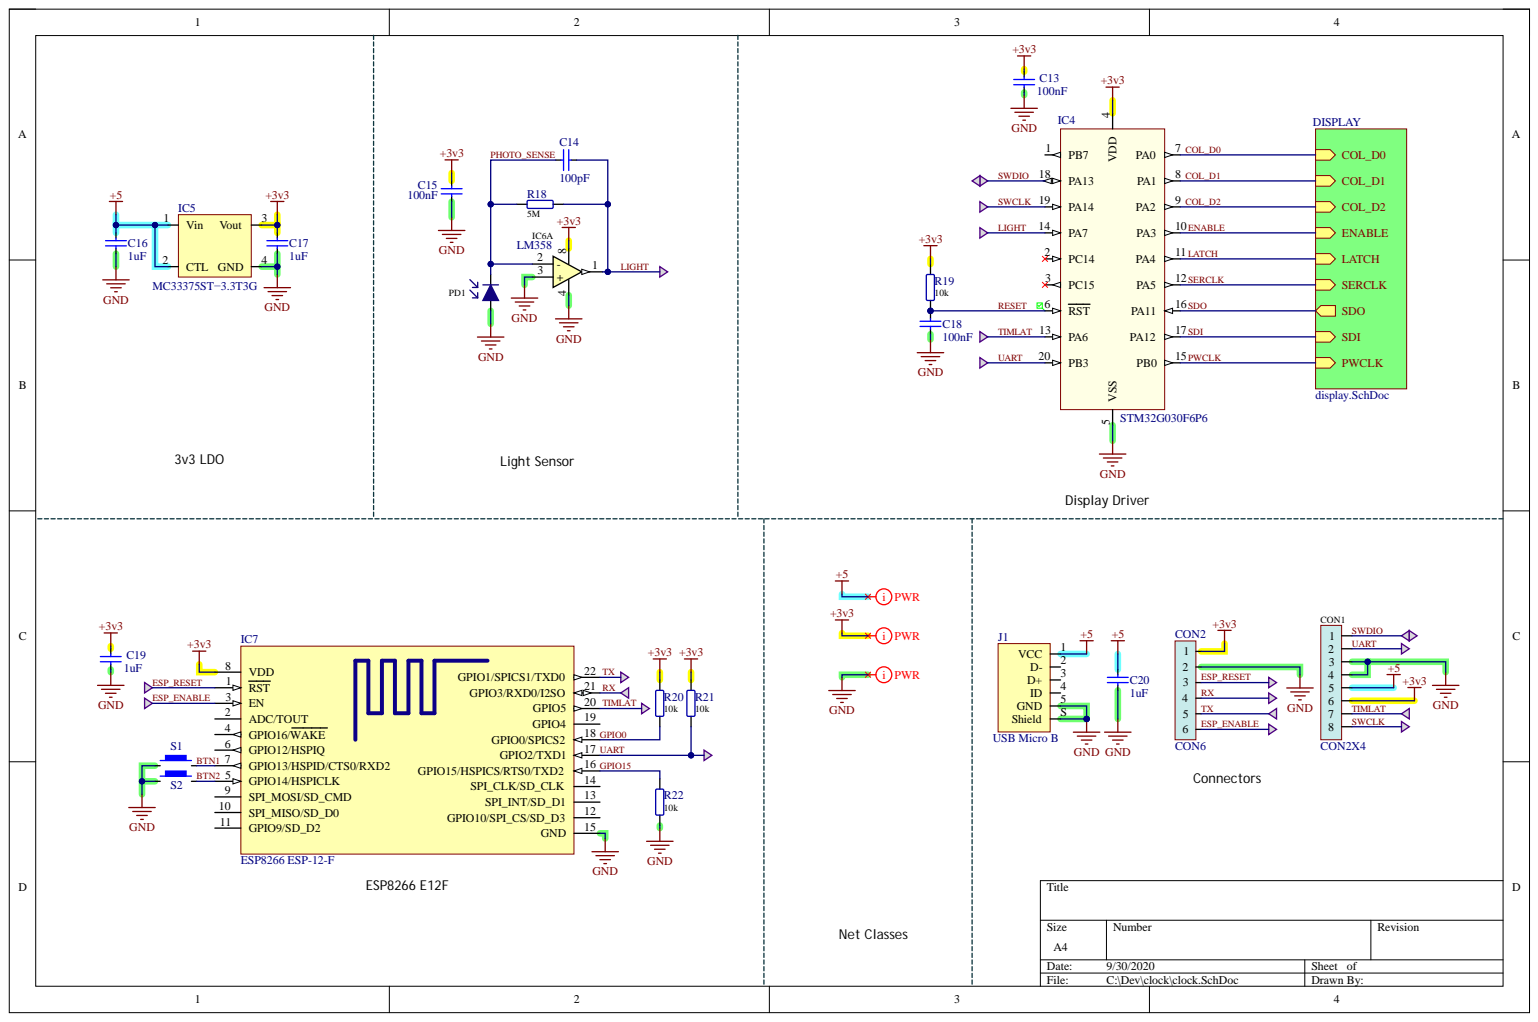
[picture p36: page 1]

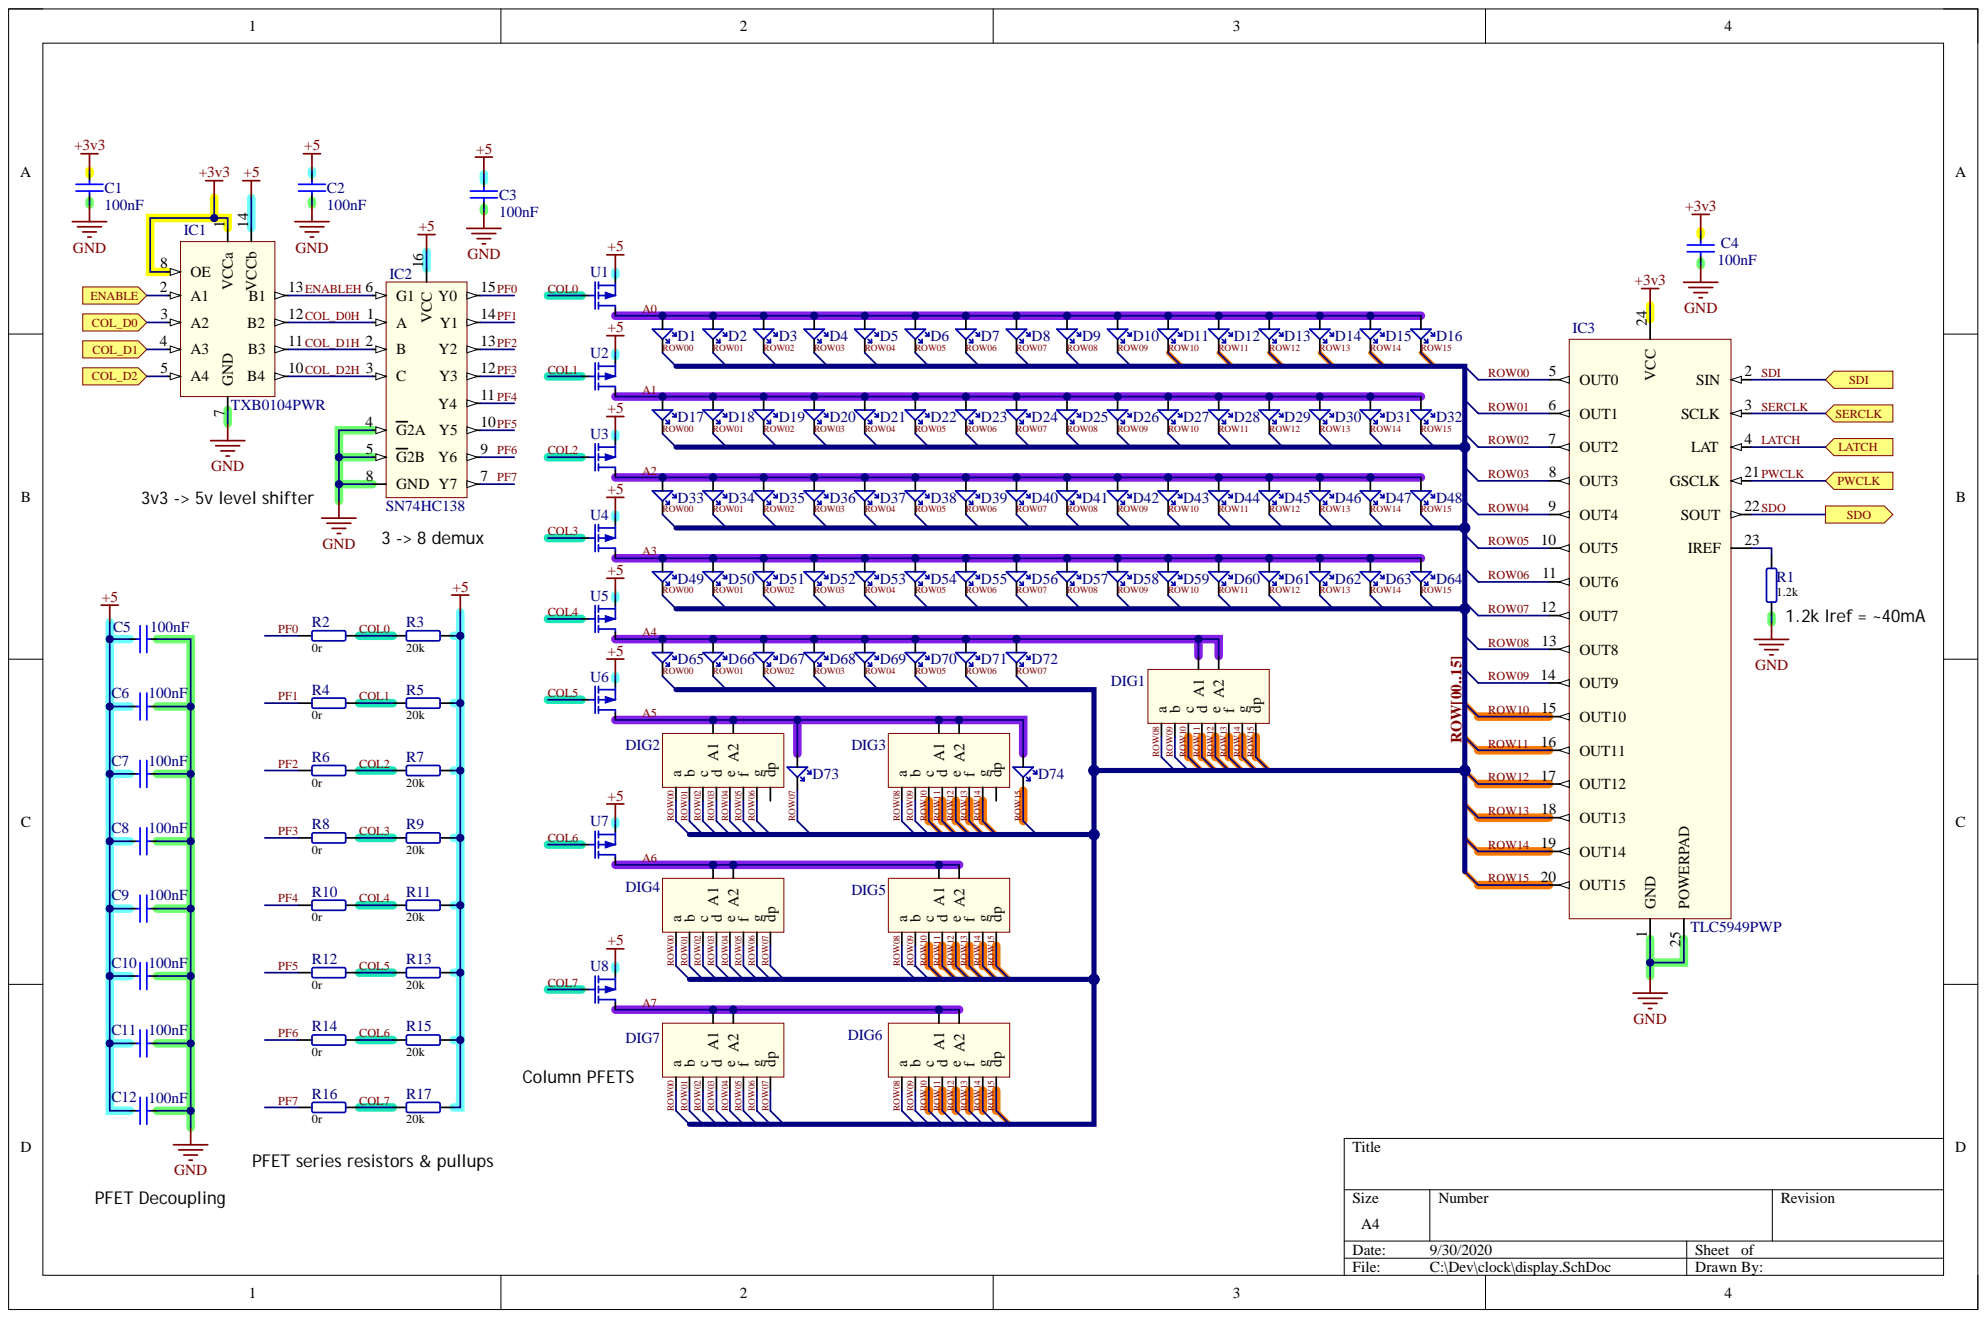
[picture p37: page 2]

PFET series resistors & pullups 20k

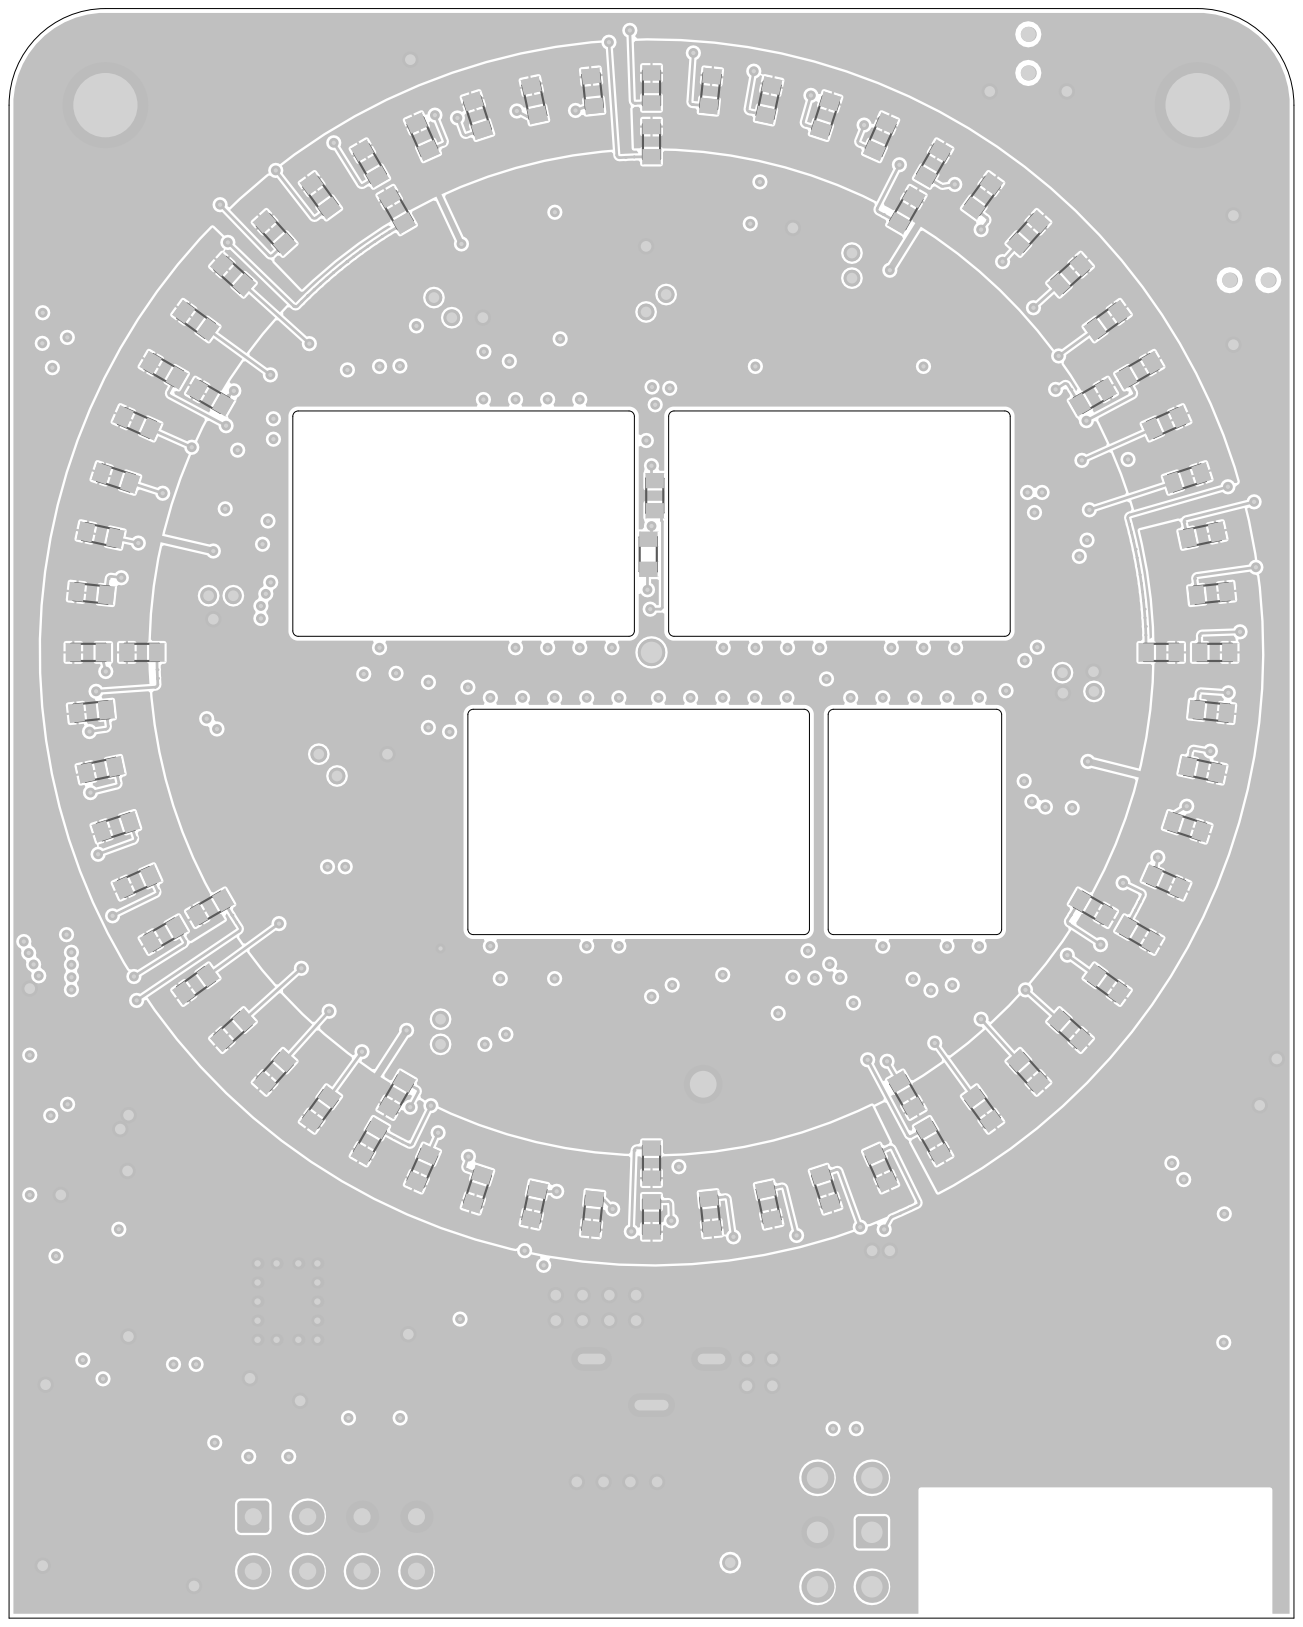
[picture p38: page 3]

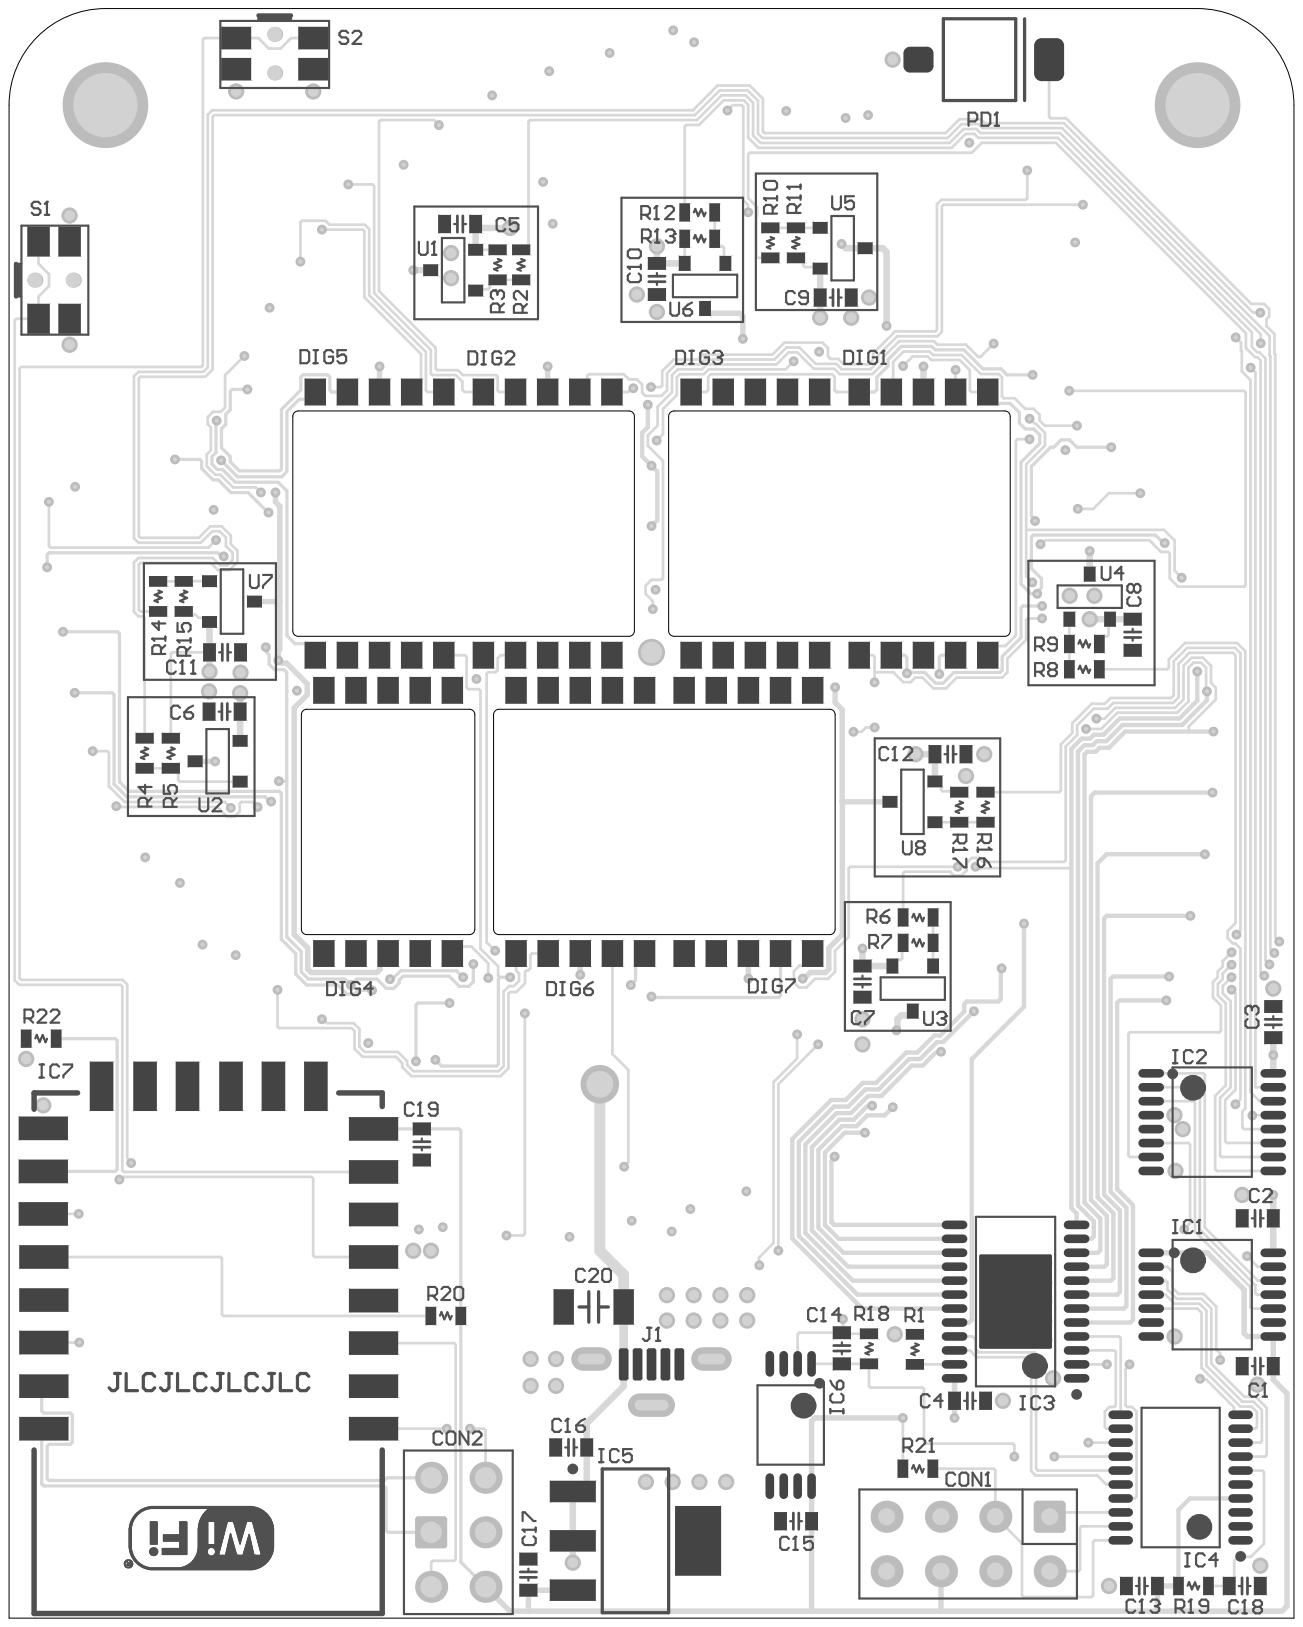
[picture p39: page 4]
