cskilbeck/clock/Outputs/2020-09-14/clock.PDF

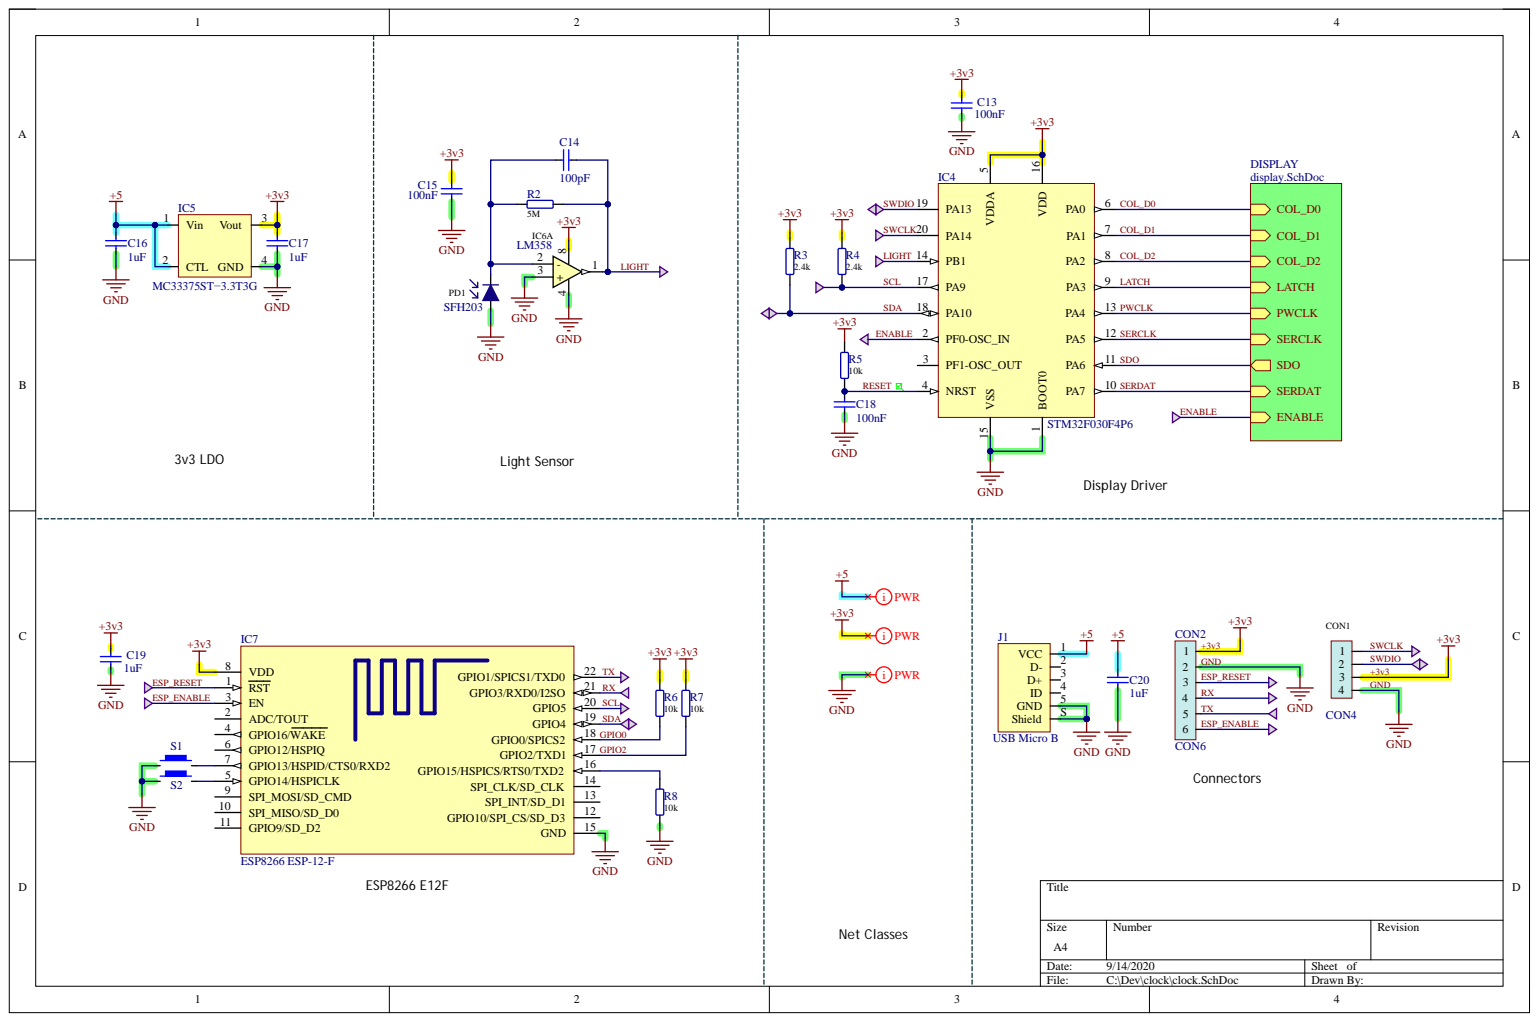
[picture p40: page 1]

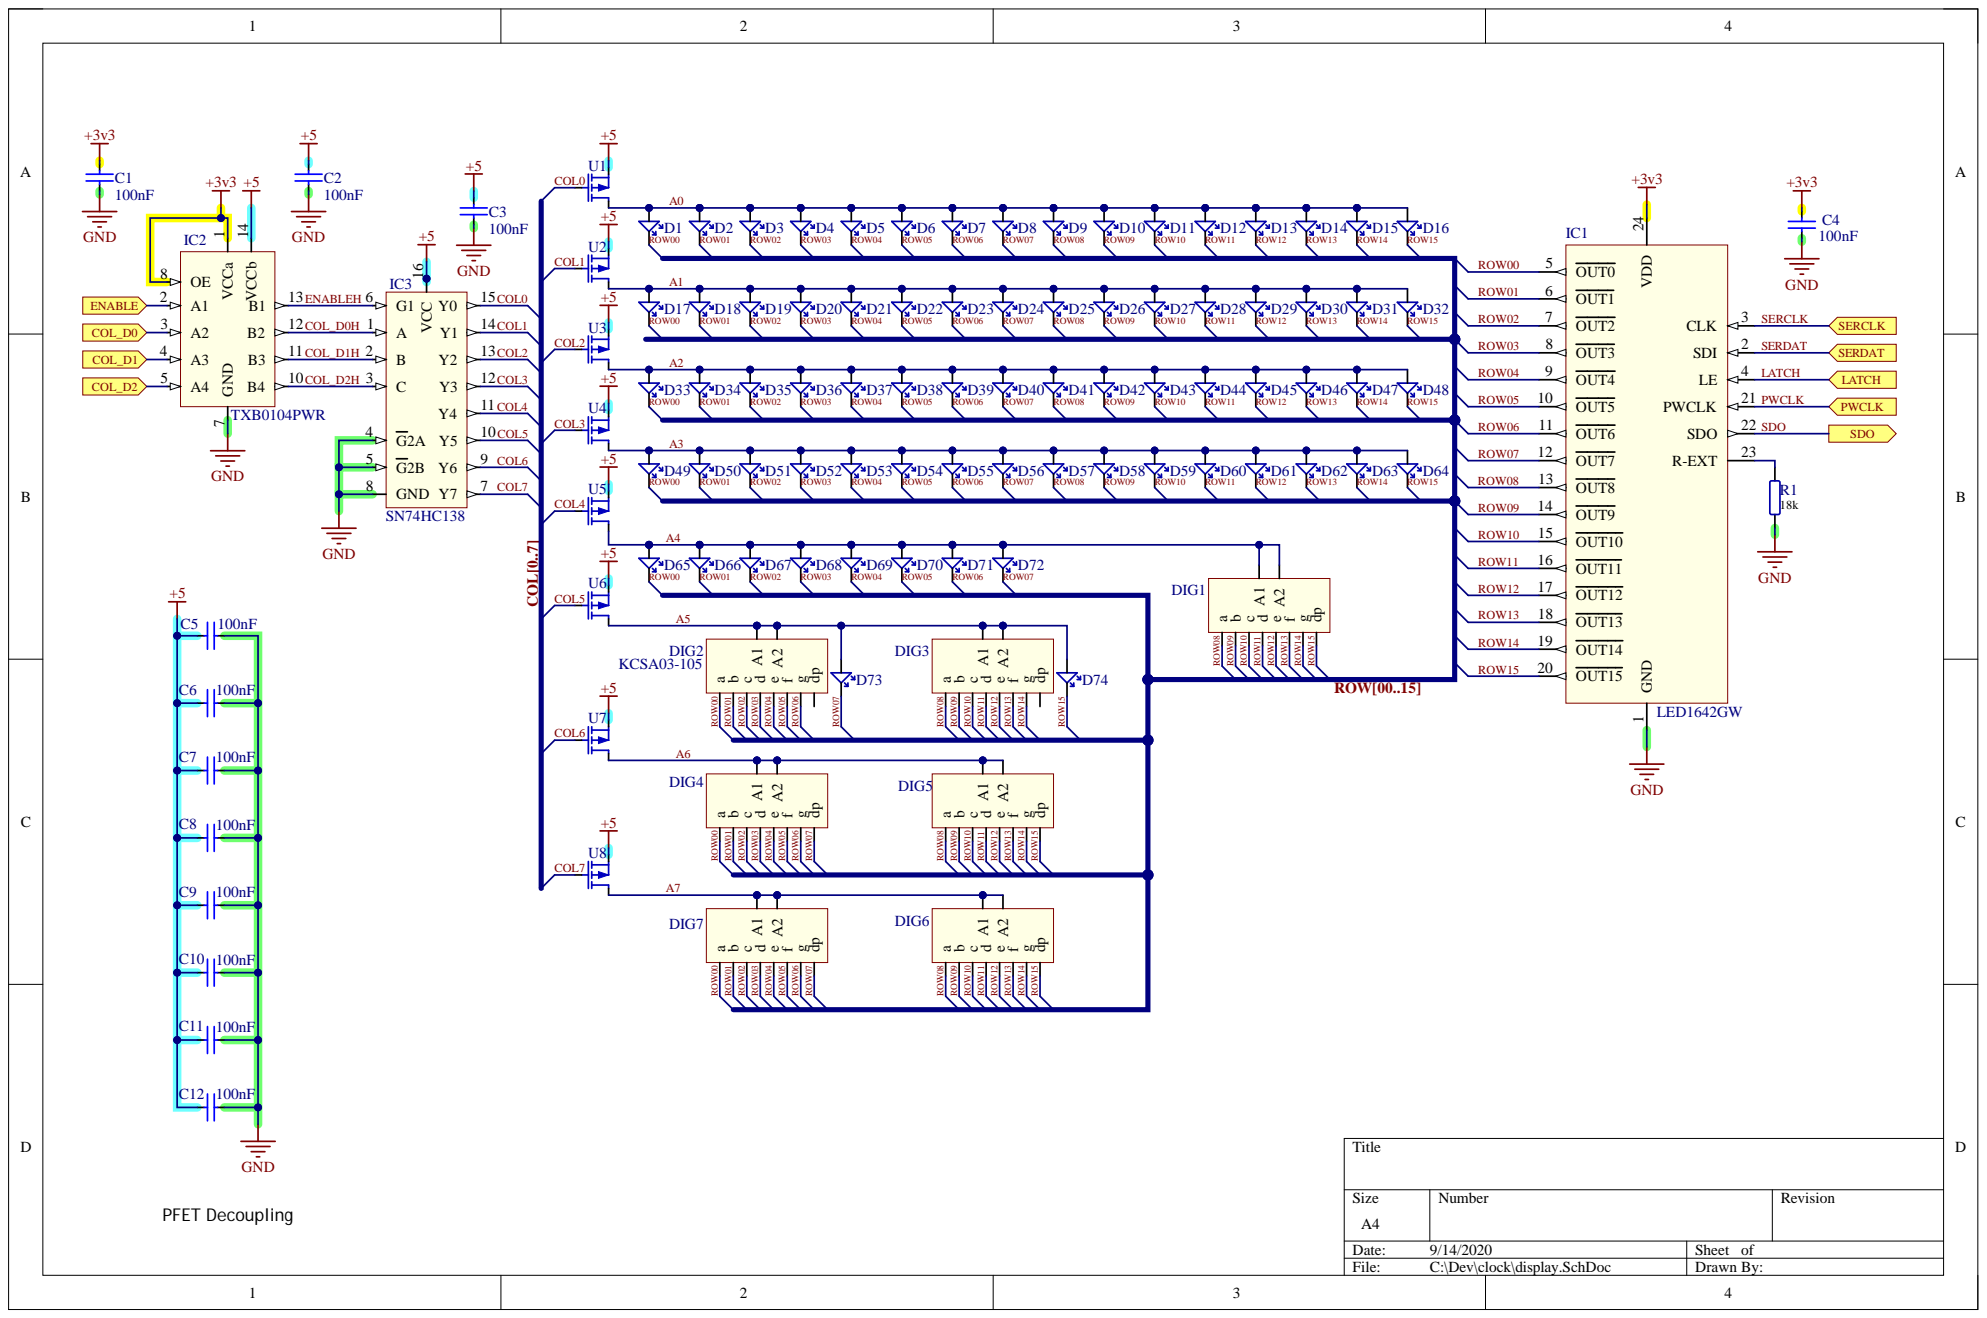
[picture p41: page 2]

5 | U5

ROW[00..15]

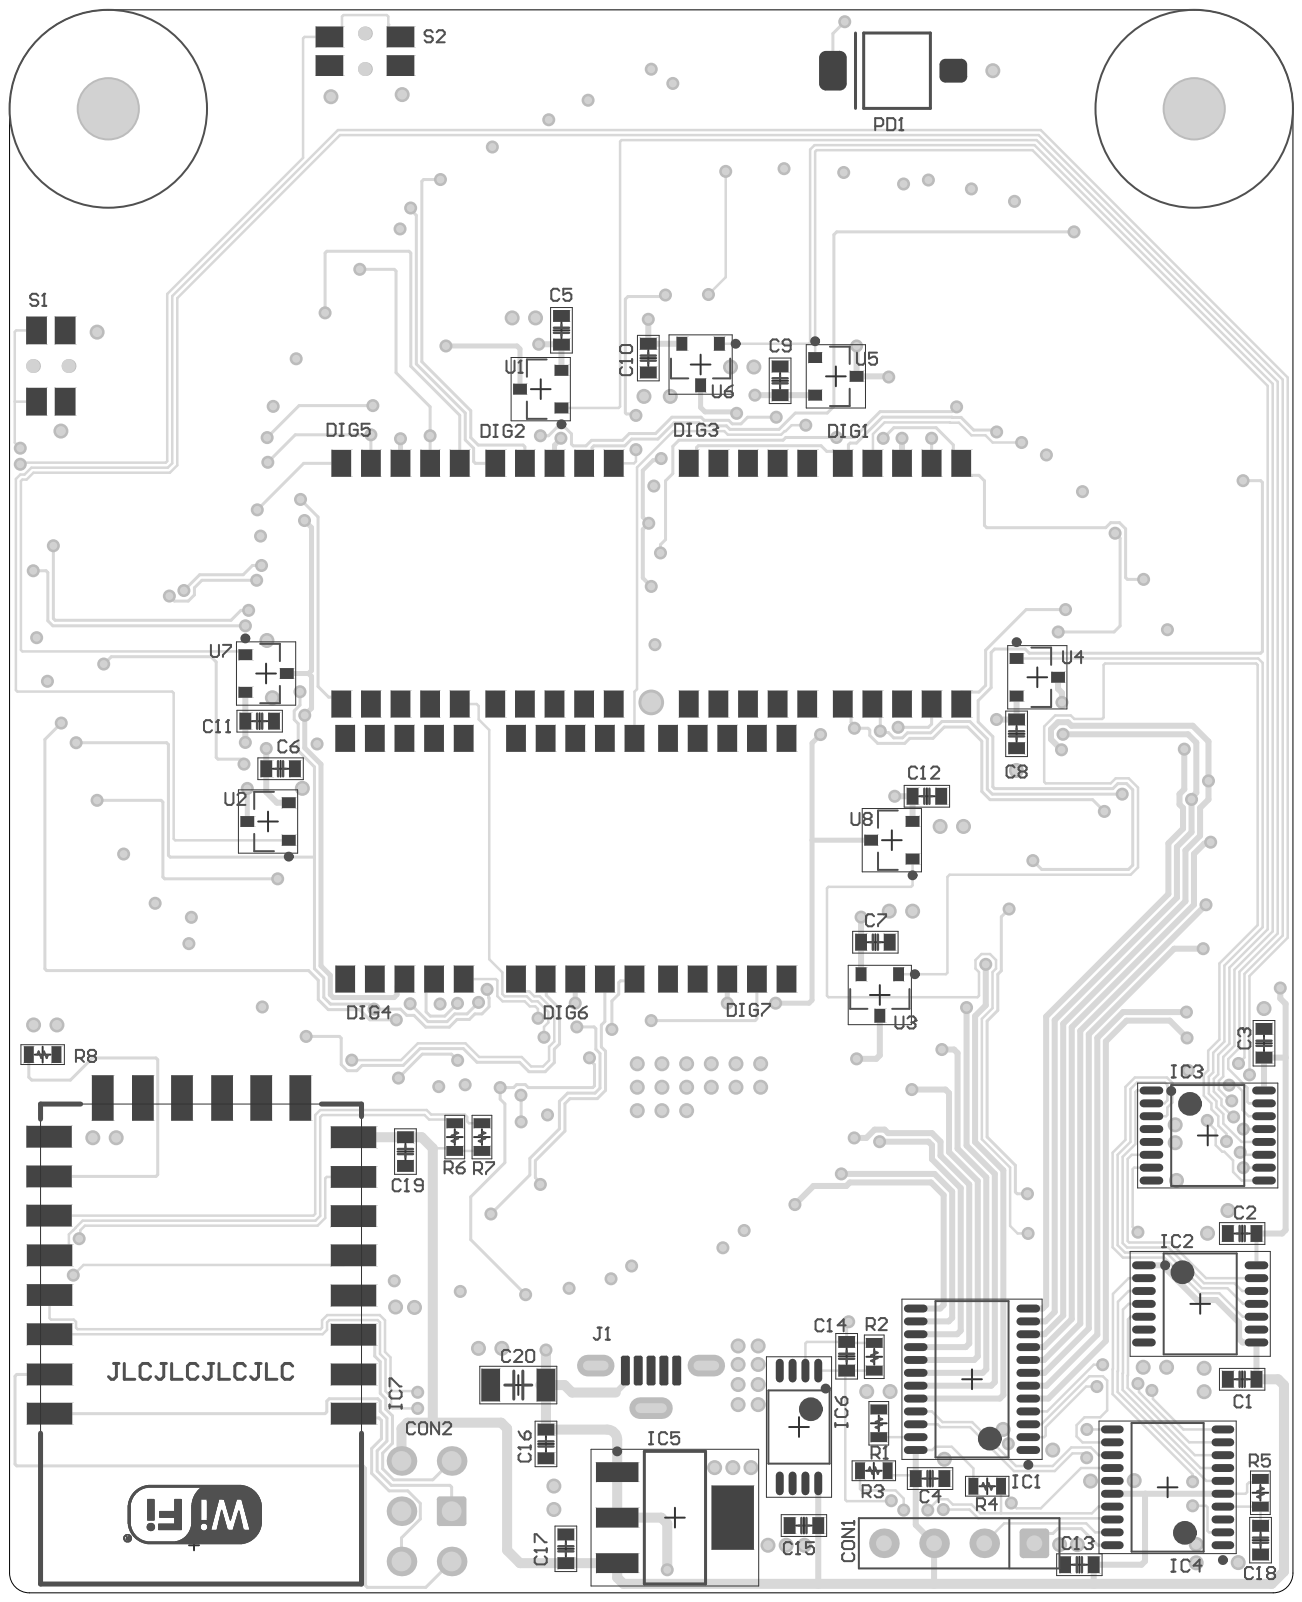
[picture p42: page 3]
