cskilbeck/clock/(list of files, drawings)

Other design files:
clock.PrjPcb
clock.SchDoc
clock.SchLib
display.SchDoc
