cskilbeck/clock/firmware3/Inc/main.h

#define GPO_DEBUG_LED_Pin LL_GPIO_PIN_7
#define GPO_DEBUG_LED_GPIO_Port GPIOB
#define GPO_COL_0_Pin LL_GPIO_PIN_0
#define GPO_COL_0_GPIO_Port GPIOA
#define GPO_COL_1_Pin LL_GPIO_PIN_1
#define GPO_COL_1_GPIO_Port GPIOA
#define GPO_COL_2_Pin LL_GPIO_PIN_2
#define GPO_COL_2_GPIO_Port GPIOA
#define GPO_COL_ENABLE_Pin LL_GPIO_PIN_3
#define GPO_COL_ENABLE_GPIO_Port GPIOA
#define GPO_LED_LATCH_Pin LL_GPIO_PIN_4
#define GPO_LED_LATCH_GPIO_Port GPIOA
#define GPI_SET_TIME_Pin LL_GPIO_PIN_6
#define GPI_SET_TIME_GPIO_Port GPIOA
#define ADC1_IN7_LIGHT_SENSE_Pin LL_GPIO_PIN_7
#define ADC1_IN7_LIGHT_SENSE_GPIO_Port GPIOA
#define TIM14_CH1_LED_PWM_Pin LL_GPIO_PIN_1
#define TIM14_CH1_LED_PWM_GPIO_Port GPIOB
#define USART1_TX_RX_Pin LL_GPIO_PIN_6
#define USART1_TX_RX_GPIO_Port GPIOB
