cskilbeck/clock/esp_http_client/main/types.h

#pragma once

//////////////////////////////////////////////////////////////////////

using byte = uint8_t;

using uint64 = uint64_t;
using uint32 = uint32_t;
using uint16 = uint16_t;
using uint8 = uint8_t;

using int64 = int64_t;
using int32 = int32_t;
using int16 = int16_t;
using int8 = int8_t;

constexpr nullptr_t null = nullptr;
