cskilbeck/clock/firmware3/Src/segments.cpp

// SEGMENT EDITOR:4020100804020100000000000000000000000000000000000000000000000000000000000000000000000000000000007e306d79335b5f707f7b00000000000000771f4e3d4f475e37303c570e57767e6773465b0f3e1c2f273b6d0000000000007d1f0d3d6f477b171038073031151d6773055b0f1c2c1a493b6d0000000000
unsigned char segments[128] = { 0x00, 0x00, 0x00, 0x00, 0x00, 0x00, 0x00, 0x00, 0x00, 0x00, 0x00, 0x00, 0x00, 0x00, 0x00, 0x00, 0x00, 0x00, 0x00, 0x00, 0x00, 0x00,
                                0x00, 0x00, 0x00, 0x00, 0x00, 0x00, 0x00, 0x00, 0x00, 0x00, 0x00, 0x00, 0x00, 0x00, 0x00, 0x00, 0x00, 0x00, 0x00, 0x00, 0x00, 0x00,
                                0x00, 0x00, 0x00, 0x00, 0x7e, 0x30, 0x6d, 0x79, 0x33, 0x5b, 0x5f, 0x70, 0x7f, 0x7b, 0x00, 0x00, 0x00, 0x00, 0x00, 0x00, 0x00, 0x77,
                                0x1f, 0x4e, 0x3d, 0x4f, 0x47, 0x5e, 0x37, 0x30, 0x3c, 0x57, 0x0e, 0x57, 0x76, 0x7e, 0x67, 0x73, 0x46, 0x5b, 0x0f, 0x3e, 0x1c, 0x2f,
                                0x27, 0x3b, 0x6d, 0x00, 0x00, 0x00, 0x00, 0x00, 0x00, 0x7d, 0x1f, 0x0d, 0x3d, 0x6f, 0x47, 0x7b, 0x17, 0x10, 0x38, 0x07, 0x30, 0x31,
                                0x15, 0x1d, 0x67, 0x73, 0x05, 0x5b, 0x0f, 0x1c, 0x2c, 0x1a, 0x49, 0x3b, 0x6d, 0x00, 0x00, 0x00, 0x00, 0x00 };
