cskilbeck/clock/(commit log)

2020-09-05 pcb: noodle
    [clock.PrjPcb, clock.SchDoc, clock.SchLib, display.SchDoc]
2020-09-05 pcb: move digits
    [clock.PrjPcb]
2020-09-06 add pvlib, start routing
    [clock.PrjPcb]
2020-09-07 start routing leds
2020-09-13 remove unused drivers
    [display.SchDoc]
2020-09-13 hal conf i2c register callbacks define
2020-09-19 driver grouping
    [clock.PrjPcb, clock.SchDoc, display.SchDoc]
2020-09-19 noodle while we wait for pcb v1
2020-09-30 JLCPCB SMT 01 TLC5949
    [clock.SchDoc, clock.SchLib, display.SchDoc]
2020-09-30 JLCPCB SMT 01
    [BOM.xlsx, Pick Place for clock.csv, Pick Place for clock.xlsx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]
2020-10-13 +steps, noodle
    [ALS_2012_0805.STEP, ALS_2012_0805_R2.step, ALS_2012_0805_R5.step, ALS_2012_0805_r3.step, ALS_2012_0805_r4.step, RK10J1_E.STEP, RK10J1_R.STEP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]
2020-10-15 going back
    [clock.SchDoc]
2020-10-17 switch on enable for demux
2020-10-17 fix digit pins
    [clock.PrjPcb, clock.SchDoc, clock.SchLib, display.SchDoc]
2020-10-17 add bom
2020-10-17 add reset to stm connector
    [clock.SchDoc]
2020-10-17 change adc params in ioc
2020-10-22 pcb noodle, add led_map xls, firmware noodle
    [LED_0603_KT-0603R.step, led_map.xlsx]
2020-10-24 pcb noodle
    [clock.SchDoc]
2020-10-27 pre move esp12
    [clock.SchDoc, display.SchDoc]
2020-10-29 add drain resistors, add segments.cpp
    [clock.SchDoc, display.SchDoc]
2020-11-05 new pc
    [ALS-PDIC144-6C.STEP, ALS-PDIC144-6C_BENT_LEGS.step, ALS-PDIC144-6C_BENT_LEGS2.step, ALS-PDIC144-6C_BENT_LEGS3.step, ALS-PDIC144-6C_BENT_LEGS4.step, DSM7UA30101.STEP, DSM7UA30101_rev01.step, DSM7UA30101_rev02.step]
2020-11-06 fix err in comment
    [user.cpp]
2020-11-18 other led digit but no
    [ACSA56-51.STEP]
2020-11-20 rejig button handler, add menu bones
2020-12-15 pcb noodle, support 3rd button, ++sntp update rate
2020-12-18 esp: tidy button read
2021-01-04 reroute wip
    [clock.PrjPcb, display.SchDoc]
